ofdouglas/2kwMotorController/README.md

# 2kwMotorController
2 kilowatt brushed DC motor controller

This is a senior design project in Electrical and Computer Engineering at George Mason University.

All works are copyrighted by their respective authors.
