ofdouglas/2kwMotorController/firmware/MotorController/sw_arch.png

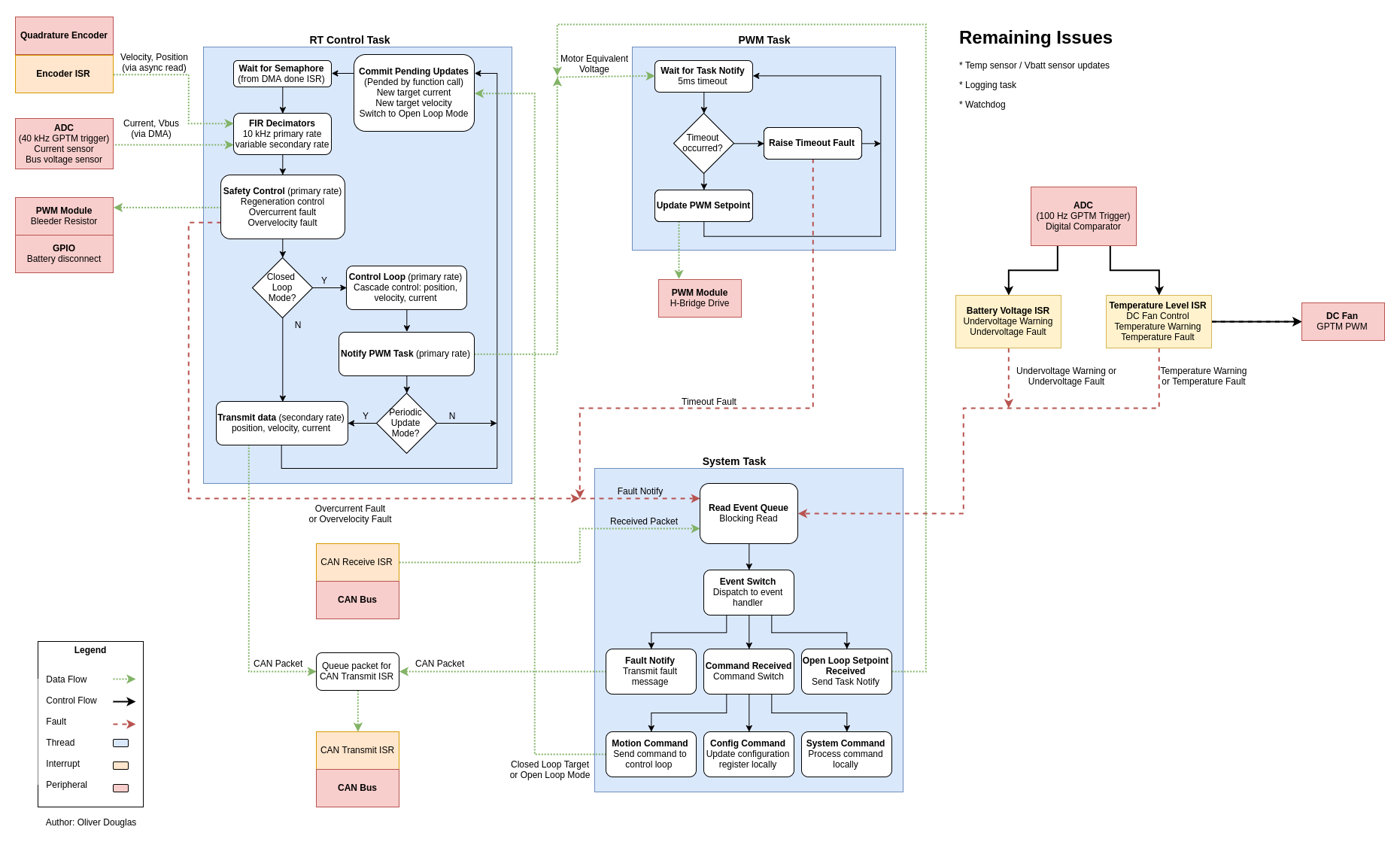
firmware/MotorController/sw_arch.png
