ofdouglas/2kwMotorController/notes/current-capacity.jpg

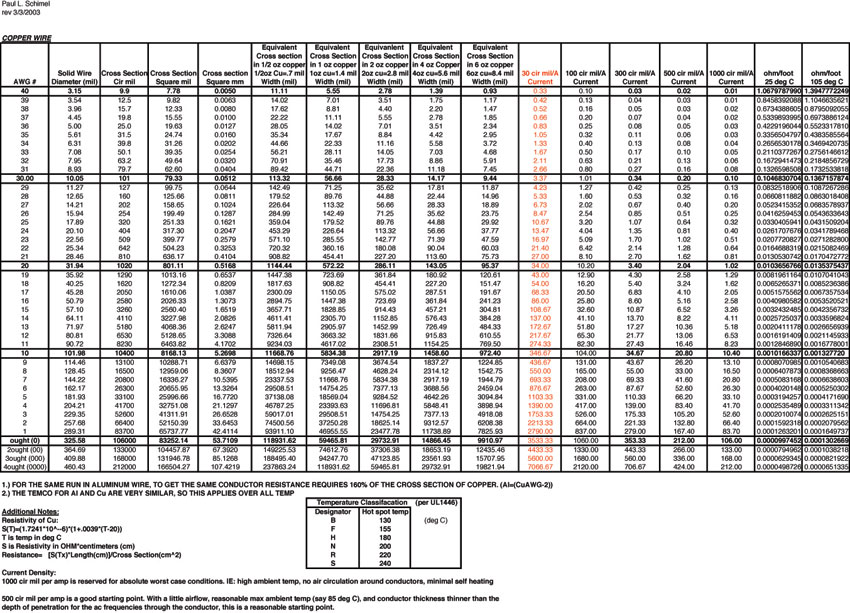
notes/current-capacity.jpg
