ofdouglas/2kwMotorController/firmware/MotorController/todo.txt

System task code
- configuration registers

improve UART command interface
- error checking
- more commands

Tune VBUS sensor

Current sensor

Test sensors over wider range
- Plot about 10 different values (ref. to multimeter)

Improve PWM driver

H-bridge safety functions

TODO: bugfixes
* panic_log_msg doesn't always work
