ofdouglas/2kwMotorController/sim/decoupling/inrush.asc

C1: cap; 1000µ
R1: res; 150
V1: voltage; PULSE(0 48 1u 1u 1n 1)
Named nets: 0, vc, vr
.tran 800m
.ic v(vc) = 0
