ofdouglas/2kwMotorController/sim/decoupling/decoupling.asc

C1: cap; 1000µ
C2: cap; {N*1µ}
I1: load; PULSE(0 45 0 50n 50n {0.5/fsw} {1/fsw})
L1: ind; 100n
L2: ind; 50n
L3: ind; 10n
L_esl: ind; {N*1.2n}
R1: res; 1m
R2: res; 150m
R3: res; 5m
R_esr: res; {N*568µ}
R_trace: res; {N*30m}
V1: voltage; 48
Named nets: 0, VC1, VC2, Vbus
.param fsw=20e3
.tran 100u
ESR = DF / (2*pi*f*C) 
Trise = 50n -> f ~= 7MHz  
Typical X7R DF for high voltage cap = 2%
MLCC Chip ESL (pF)
0603: 870
0805: 1050
1206: 1200
1210: 980
.param N = 1
Power loss in capacitors: V(VC2)*I(C2)
Peak power is a few watts, average power ~= 0
Power line inductance:
Microstrip over ground plane: L = 2h/w nH/cm
Cable in air: L = 2l(log(l/(t+w) + 1/2) nH (cm) 
(For a big cable: several nH/cm)
Very low R_trace is bad for stability (undamped LC, step excitation)
but watch for trace heating due to large transient current...
especially if significant ringing occurs
Aluminum Electrolytic
Ceramic (SMD)
