ofdouglas/2kwMotorController/sim/supply/lt3471.asc

C1: cap; 56p
C2: cap; 4.7µ; Rser=10m
C3: cap; 1µ
C4: cap; 4.7µ
C5: cap; 100n
C6: cap; 56p
C7: cap; 4.7µ
C8: cap; 0.1µ
D1: schottky; PMEG2005AEA
D2: schottky; PMEG2005AEA
I1: load; PWL(0 0 1m 0 1.001m 250m)
L1: ind; 10µ; Rser=182m
L2: ind; 10µ
L3: ind; 10µ
R1: res; 110k
R2: res; 10k
R3: res; 10k
R4: res; 120k
R5: res; 2.4k
R6: res; 2.4k
R7: res; 10k
RTEST: res; 1µ
U1: LT3471
V1: voltage; 7
Named nets: +12V, 0, -12V, SHDN
.tran 2.5m
.ic V(SHDN)=0
