ofdouglas/2kwMotorController/sim/hbridge-spice/proto.asc

C1: cap; 470µ; Rser=100m
C2: cap; 0.22µ
C4: cap; 0.22µ
C5: cap; 0.1µ
D1: diode; 1N4148
D2: diode; 1N4148
I_load_torque_external: current; 1
L6: ind; 1µ
L_parasitic_1: ind; 10n; Rser=1m
L_parasitic_2: ind; 10n; Rser=1m
L_parasitic_3: ind; 10n; Rser=1m
L_parasitic_4: ind; 10n; Rser=1m
M1: nmos; IPP037N08N3
M2: nmos; IPP037N08N3
M3: nmos; IPP037N08N3
M4: nmos; IPP037N08N3
M5: nmos; IPP037N08N3
M6: nmos; IPP037N08N3
M7: nmos; IPP037N08N3
M8: nmos; IPP037N08N3
R1: res; 5.1
R2: res; 5.1
R3: res; 5.1
R4: res; 5.1
R5: res; 5.1
R6: res; 27k
R7: res; 5.1
R8: res; 5.1
R9: res; 27k
R10: res; 5.1
Rsense: res; 1n
U1: voltage; 48; Rser=1m
U2: LM5106_TRANS
U3: cap; 0.1µ
U4: LM5106_TRANS
V1: voltage; PULSE(0 5 0 10n 10n 10e-6 50e-6 150)
V2: voltage; PULSE(0 5 0.0075 10n 10n 10e-6 50e-6 50)
V3: voltage; 5
VDD: voltage; 10; Rser=100m
X1: DC_motor_model
Named nets: 0, EN, IN_1, IN_2, VDD, M-, M+, omega
.tran 0.005
.lib LM5106_TRANS.lib
