ofdouglas/2kwMotorController/sim/hbridge-spice/brake/DC_motor_model.asc

Aenc: schmtinv; Vt=0.5 Vh=0.5 td=10n
Bemf: bv; V=k*V(omega)
Benc: bv; V=5*V(p)
Bp: bi; I=kenc*abs(v(omega))*(V(p)-0.5)
C_Jinertia: cap; {J}
Cenc: cap; 1m
I_load_torque_int: bi; I=sgn(v(omega))*min(Tint,0.1*abs(v(omega)))
Itorque: bi; I=k*I(Bemf)
LM: ind; 120µH
R1: res; 220
R_Bfriction: res; {1/B}
RM: res; {RM}
Named nets: enc, 0, omega, emf, p, +DC, -DC
.param kenc=0.49
ECEN2830
DC motor model
wheel speed [rad/s]
Encoder pulses
Encoder model
.param RM = 0.089
.param k = 0.0398
.param J = 0.064516
.param B = 0.0001
.param Tint = 0.05
Update These Parameters
(Do not make any other changes)
Electrical Model
Mechanical Model
E30-400 Unloaded:
.param RM = 0.089
.param k = 0.0398
.param J = 0.001256
.param B = 0.0001
.param Tint = 0.05
