ofdouglas/2kwMotorController/sim/sensor-spice/opto/photovoltaicMode.asc

C1: cap; 10p
C2: cap; 10p
C3: cap; 47n
R1: res; 470
R2: res; 120k
R3: res; 51k
R4: res; 47
R5: res; 18k
R6: res; 2k
U1: CNR200
U2: UniversalOpamp2; Avol=1Meg GBW=1Meg Slew=0.6Meg; ilimit=25m rail=0 Vos=0 phimargin=90
U3: UniversalOpamp2
U4: UniversalOpamp2; Avol=1Meg GBW=1Meg Slew=0.6Meg; ilimit=25m rail=0 Vos=0 phimargin=90
V1: voltage; 11.5
V2: voltage; 3.3
V3: voltage; ""; AC 1
V4: voltage; 10
V5: voltage; 0
Voffset: voltage; 6m
Named nets: 0, Vin, 10V, Vout, Vcc2, Vcc, VCC
.dc V3 1 75 0.1
.ac dec 100 1 10Meg
Vout = Vin * K3 * R3 / R2
K3 ~= 1
.param A = 0.0425
normalize V(vout) to 0dB: V(vout)*6700
