ofdouglas/2kwMotorController/sim/hbridge-spice/brake/busbrake-quick.asc

A1: and
A3: schmtbuf; Vt={Vbatt+1} Vh=0.5
C1: cap; 2mF; Rser=100m
C2: cap; 100n
E1: e; 10
L1: ind; 120µ
M1: nmos; IPP100N08N3
M2: nmos; IPP100N08N3
M3: nmos; IPP100N08N3
M4: nmos; IPP100N08N3
M5: nmos; IPP100N08N3
M6: nmos; IPP100N08N3
Motor: res; 0.089
R1: res; 800
Rbrake: res; 1; pwr=200
Rsense: res; 1µ
V4: voltage; PULSE(0 1 0 1n 1n 0e-6 50e-6)
Vbrake: voltage; 0
Vbus: voltage; {Vbatt}; Rser=2m
Vbus_dis: voltage; PWL(0 10 {t_drive} 10 {t_drive + 0.1m} 0)
Vdir: voltage; 0
Vduty: voltage; PWL(0 0.42 {t_drive} 0.98 {t_drive + 0.1m} 0.21)
Vgen: voltage; 20
Vmode: voltage; 1
X1: GateDriver
Named nets: Vduty, 0, Vdir, Vbrake, Vmode, M+, M-, HO1, LO1, HO2, LO2, Vbus
.tran {t_drive + 0.05}
.param t_drive=0.02
.param Vbatt=48V
.ic I(L1)=90A
