ofdouglas/2kwMotorController/sim/hbridge-spice/brake/busbrake.asc

A1: and
A3: schmtbuf; Vt={Vbatt+1} Vh=1
C2: cap; 100n
Cbus: cap; 1mF; Rser=50m
D1: schottky; MBR735
D2: schottky; MBR735
D3: schottky; MBR735
D4: schottky; MBR735
E1: e; 10
E2: e; 9.55e-3
I1: current; 0.1
M1: nmos; IPP100N08N3
M2: nmos; IPP100N08N3
M3: nmos; IPP100N08N3
M4: nmos; IPP100N08N3
M5: nmos; IPP100N08N3
M6: nmos; IPP100N08N3
Motor: res; 1µ
R1: res; 800
R2: res; 250
R3: res; 250
R4: res; 250
R5: res; 250
Rbrake: res; 1; pwr=200
Rsense: res; 1µ
V4: voltage; PULSE(0 1 0 1n 1n 50e-6 50e-6)
Vbattery: voltage; {Vbatt}; Rser=2m
Vbrake: voltage; 0
Vbus_dis: voltage; PWL(0 10 {t_drive} 10 {t_drive + 0.1m} 0)
Vdir: voltage; 0
Vduty: voltage; PWL(0 0.98 {t_drive} 0.98 {t_drive + 0.1m} 0.3)
Vmode: voltage; 1
X1: GateDriver
X2: DC_motor_model
Named nets: Vduty, 0, Vdir, Vbrake, Vmode, M+, M-, HO2, HO1, LO1, LO2, Vbus, rad/s, krpm
.tran {t_drive + 0.1}
.param t_drive=0.1
.param Vbatt=48V
Demonstration of regenerative braking effect when
reducing duty cycle in sign-magnitude drive mode.
 
If Vbus_dis remains on, Vbattery will overcharge.
If Vbus_dis is turned off, but Rbrake is not utilized,
Vbus will become overcharged.
Brake power: V(Vbus,N001)*I(Rbrake)
