ofdouglas/2kwMotorController/sim/sensor-spice/hall/hallsensor.asc

C1: cap; 47n
C2: cap; 27n
Isense: current; PULSE(0 50mA 100u 1n 0 1 1); AC 1
R1: res; 100k
R2: res; 100k
R3: res; 33
Radj: res; 59.0
Rsense: res; 59.0; pwr=0.2
U3: ADA4805
VDDA: voltage; 3.3
VREF: voltage; 3.0
Named nets: 0, Vadc, Vsense
.dc Isense 0 45m 1m
.param fpwm 20k
.tran 2m
I_sense value for ripple current sim:
PULSE(10 12mA 0 {0.5/fpwm} {0.5/fpwm} 0 {1/fpwm})
.op
200mW
0.1%
I_primary = (Vadc - 1.50) * 67.8
I_sense = I_motor / 2000
RRIO op amp
SAR ADC input drive
stable dielectric 
such as C0G
.ac dec 100 1 10Meg
