ofdouglas/2kwMotorController/sim/hbridge-spice/brake/BrakeResistor.asc

L1: ind; 120µH
M1: nmos; IPB016N06L3
M3: pmos; RSS070P05
R1: res; 0.1
R2: res; 1
V1: voltage; 24
V2: voltage; PULSE(0 10 0 1n 1n 44e-6 50e-6)
Named nets: 0, pwm
.tran 10m
DC motor equivalent
Brake resistor
