ofdouglas/2kwMotorController/sim/hbridge-spice/brake/GateDriver.asc

A1: and
A2: inv
A3: inv
A4: or
A5: and
A6: and
A7: and
A8: inv
A9: inv
A10: inv
A11: and
A12: or
A13: inv
A14: inv
A16: and
A18: and
A19: or
A20: inv
A21: and
A23: inv
A24: inv
A25: inv
A26: and
A27: inv
A32: and
A34: inv
A36: inv
E1: e; 10V
E2: e; 10V
E3: e; 10V
E4: e; 10V
R1: res; 1Meg
R2: res; 1Meg
R3: res; 1Meg
R4: res; 1Meg
U1: LTC6752
V2: voltage; PULSE(0 1 0 {0.99/fs} {0.01/fs} 0 {1/fs})
VDD: voltage; 5
Named nets: 0, PWM, DIR, BRAKE, MODE, LO2_EN, LO1_EN, HO1_EN, HO2_EN, HS1, HO1, HS2, HO2, LO1, LO2, DUTY, Vsawtooth
.param fs=20kHz
Apply a DC voltage between 0 and 1V to the DUTY, MODE,  
BRAKE, and DIR inputs. Or use the 'PWL' voltage source to  
create step changes in these inputs.
 
DUTY: analog signal controlling duty cycle (0.4V = 40%, etc) 
           when BRAKE is applied, this controls brake/coast ratio 
 
MODE:    digital signal: 0 = coast; 1 = short.
BRAKE: digital signal: 0 = drive; 1 = brake. 
DIR:         digital signal: 0 = clockwise (M+ -> M-)
