ofdouglas/2kwMotorController/sim/hbridge-spice/drive-modes/async_sm-discontinuous.asc

L1: ind; 120µH
M1: nmos; IPP037N08N3
M2: nmos; IPP037N08N3
M3: nmos; IPP037N08N3
M4: nmos; IPP037N08N3
Motor: res; 1n
R1: res; 10
R2: res; 10
R3: res; 10
R4: res; 10
R5: res; 10
R6: res; 0.089
V1: voltage; PULSE(0 20 0 1n 1n 45e-6 50e-6 200)
V2: voltage; 50
V3: voltage; PULSE(0 20 10m 1n 1n 15e-6 50e-6)
V_bus: voltage; 24; Rser=0
V_gen: voltage; 20
Named nets: 0, M-, M+
.tran 0.02
Demonstration of discontinuous conduction mode at low duty cycle:
 Switch from 90% duty cycle to 30% duty cycle after 10 ms
 Because V_bus * Duty < V_gen, average motor current is zero
Asynchronous Sign-Magnitude Drive Mode (AKA unipolar 2-quadrant PWM)
