ofdouglas/2kwMotorController/sim/sensor-spice/opto/opto-amp-gain.asc

D1: diode; 1N4148
E1: e; 100k
F1: f; E1; 0.007
R1: res; 10k
R2: res; 470
V1: voltage; 48
V2: voltage; 12
Named nets: 0, Vout, Vin
.tf V(Vout) V1
