ofdouglas/2kwMotorController/hardware/2kwMotorController.kicad_pcb

## KiCad design hardware/2kwMotorController.kicad_pcb (2017-11-27)

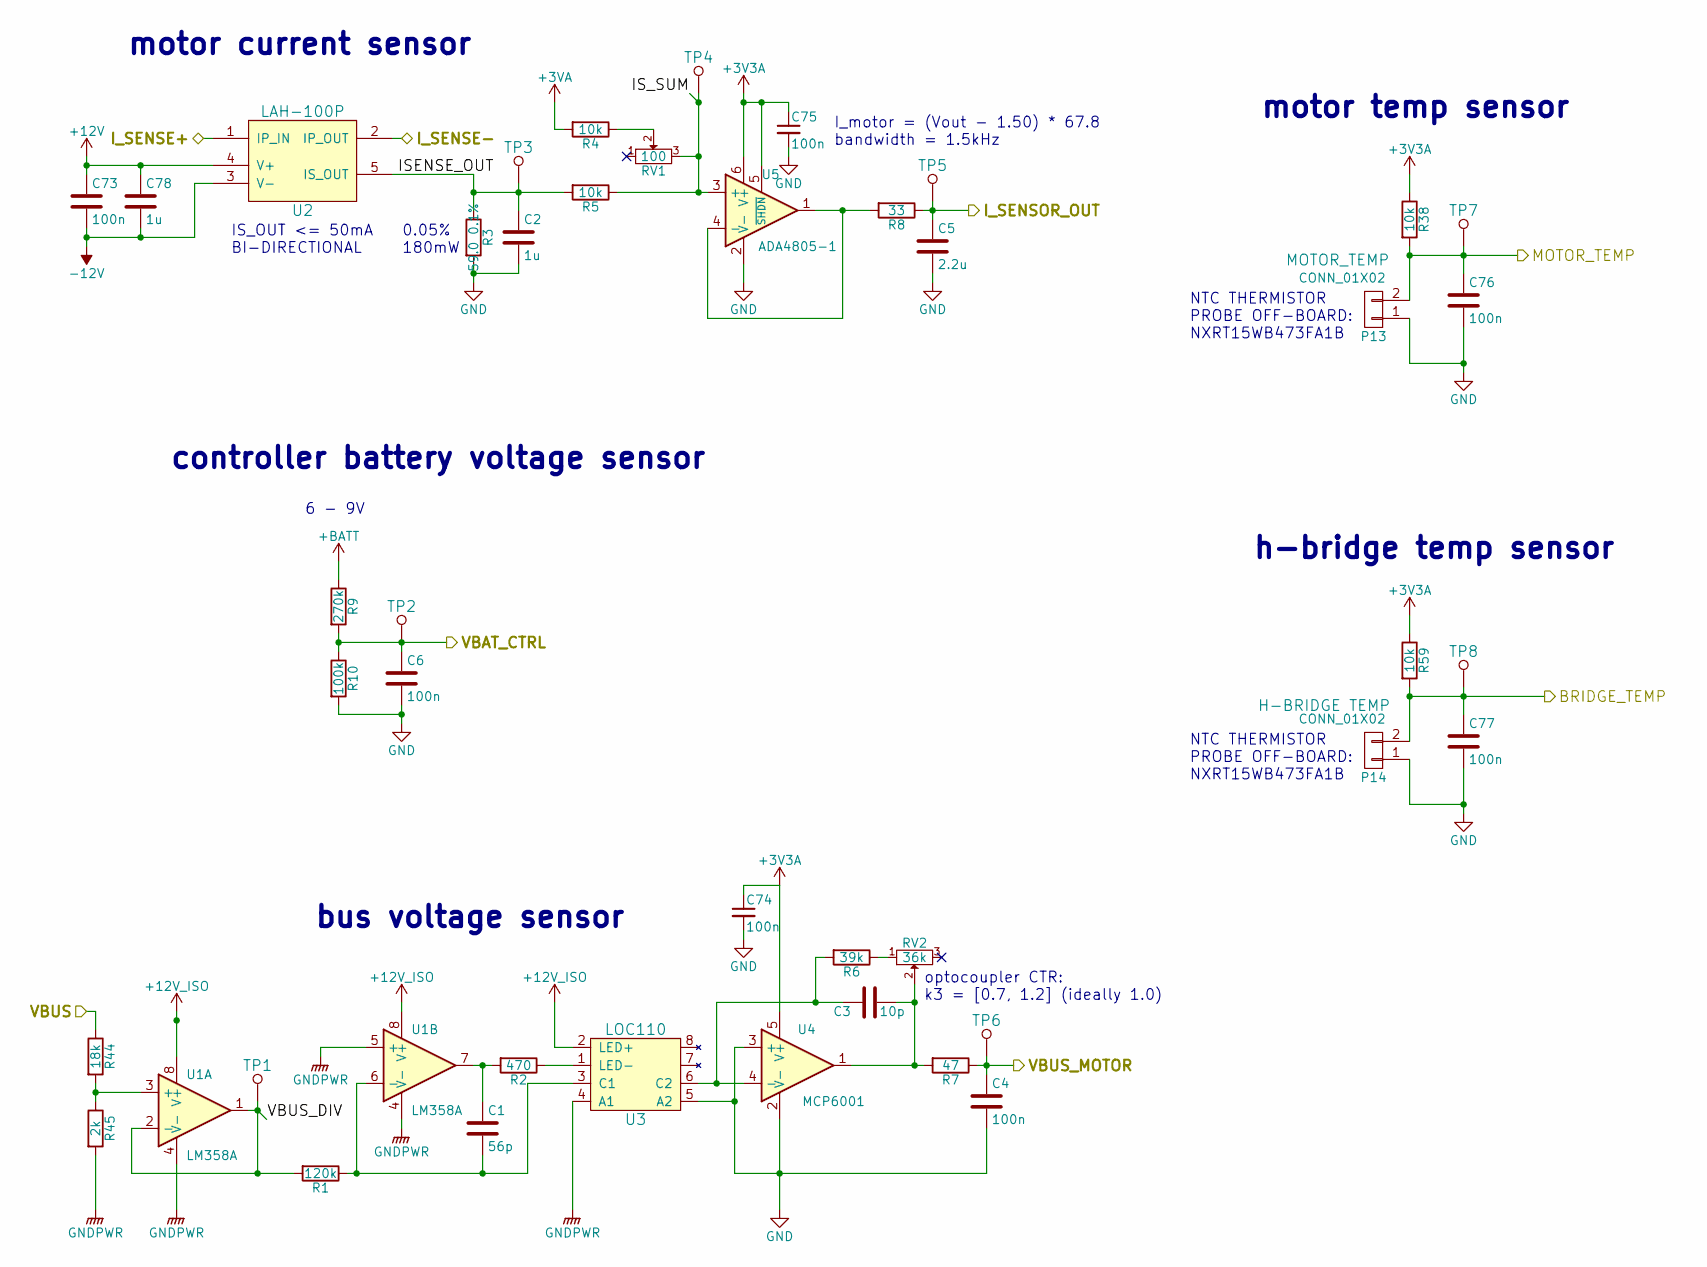
[picture p3: schematic sensors.sch]

Parts:
C1: 56p; C_0603; Voltage 16V
C2: 1u; C_0603; Voltage 16V
C3: 10p; C_0603; Voltage 16V
C4, C6, C74, C75, C76, C77: 100n; C_0603; Voltage 16V
C5: 2.2u; C_0603; Voltage 16V
C73: 100n; C_0603; Voltage 25V
C78: 1u; C_0603; Voltage 25V
P13, P14: CONN_01X02; Pin_Header_Straight_1x02
R1: 120k; R_0603
R2: 470; R_0603
R3: 59.0 0.1%; R_1206
R4, R5, R38, R59: 10k; R_0603
R6: 39k; R_0603
R7: 47; R_0603
R8: 33; R_0603
R9: 270k; R_0603
R10: 100k; R_0603
R44: 18k; R_0603
R45: 2k; R_0603
RV1: 100; Trimpot-23B
RV2: 36k; Trimpot-23B
TP1, TP2, TP3, TP4, TP5, TP6, TP7, TP8: TEST_POINT; TEST_PAD_1.27mm
U1: LM358A; SOIC-8_3.9x4.9mm_Pitch1.27mm
U2: LAH-100P; LAH_100-P
U3: LOC110; DIP-8_SMD
U4: MCP6001; SC-70-5
U5: ADA4805-1; SOT-23-6

Connections:
+3V3A: C74.1, C75.1, R38.1, R59.1, U4.5 (V+), U5.5 (~SHDN), U5.6 (V+); also elsewhere on the board
+3VA: R4.2; also elsewhere on the board
+12V: C73.1, C78.1, U2.4 (V+); also elsewhere on the board
+12V_ISO: U1.8 (V+), U3.2 (LED+); also elsewhere on the board
+BATT: R9.1; also elsewhere on the board
-12V: C73.2, C78.2, U2.3 (V-); also elsewhere on the board
/h-bridge/I_SENSE+: U2.1 (IP_IN); also elsewhere on the board
/h-bridge/I_SENSE-: U2.2 (IP_OUT); also elsewhere on the board
/h-bridge/VBUS: R44.1; also elsewhere on the board
/mcu/BRIDGE_TEMP: C77.1, P14.2, R59.2, TP8.1; also elsewhere on the board
/mcu/I_SENSOR_OUT: C5.1, R8.1, TP5.1; also elsewhere on the board
/mcu/MOTOR_TEMP: C76.1, P13.2, R38.2, TP7.1; also elsewhere on the board
/mcu/VBAT_CTRL: C6.1, R9.2, R10.1, TP2.1; also elsewhere on the board
/mcu/VBUS_MOTOR: C4.1, R7.1, TP6.1; also elsewhere on the board
/sensors/ISENSE_OUT: C2.1, R3.1, R5.2, TP3.1, U2.5 (IS_OUT)
/sensors/IS_SUM: R5.1, RV1.3, TP4.1, U5.3 (+)
/sensors/VBUS_DIV: R1.2, TP1.1, U1.1, U1.2 (-)
GND: C2.2, C4.2, C5.2, C6.2, C74.2, C75.2, C76.2, C77.2, P13.1, P14.1, R3.2, R10.2, U3.5 (A2), U4.2 (V-), U4.3 (+), U5.2 (V-); also elsewhere on the board
GNDPWR: R45.2, U1.4 (V-), U1.5 (+), U3.4 (A1); also elsewhere on the board
unnamed: C1.1, R2.2, U1.7
unnamed: C1.2, R1.1, U1.6 (-), U3.3 (C1)
unnamed: C3.1, R6.2, U3.6 (C2), U4.4 (-)
unnamed: C3.2, R7.2, RV2.2, U4.1
unnamed: R2.1, U3.1 (LED-)
unnamed: R4.1, RV1.2
unnamed: R6.1, RV2.1
unnamed: R8.2, U5.1, U5.4 (-)
unnamed: R44.2, R45.1, U1.3 (+)

Notes on the sheet:
IS_OUT <= 50mA BI-DIRECTIONAL
motor current sensor
h-bridge temp sensor
controller battery voltage sensor
bus voltage sensor
6 - 9V
optocoupler CTR: k3 = [0.7, 1.2] (ideally 1.0)
I_motor = (Vout - 1.50) * 67.8 bandwidth = 1.5kHz
0.05% 180mW
motor temp sensor
NTC THERMISTOR PROBE OFF-BOARD: NXRT15WB473FA1B

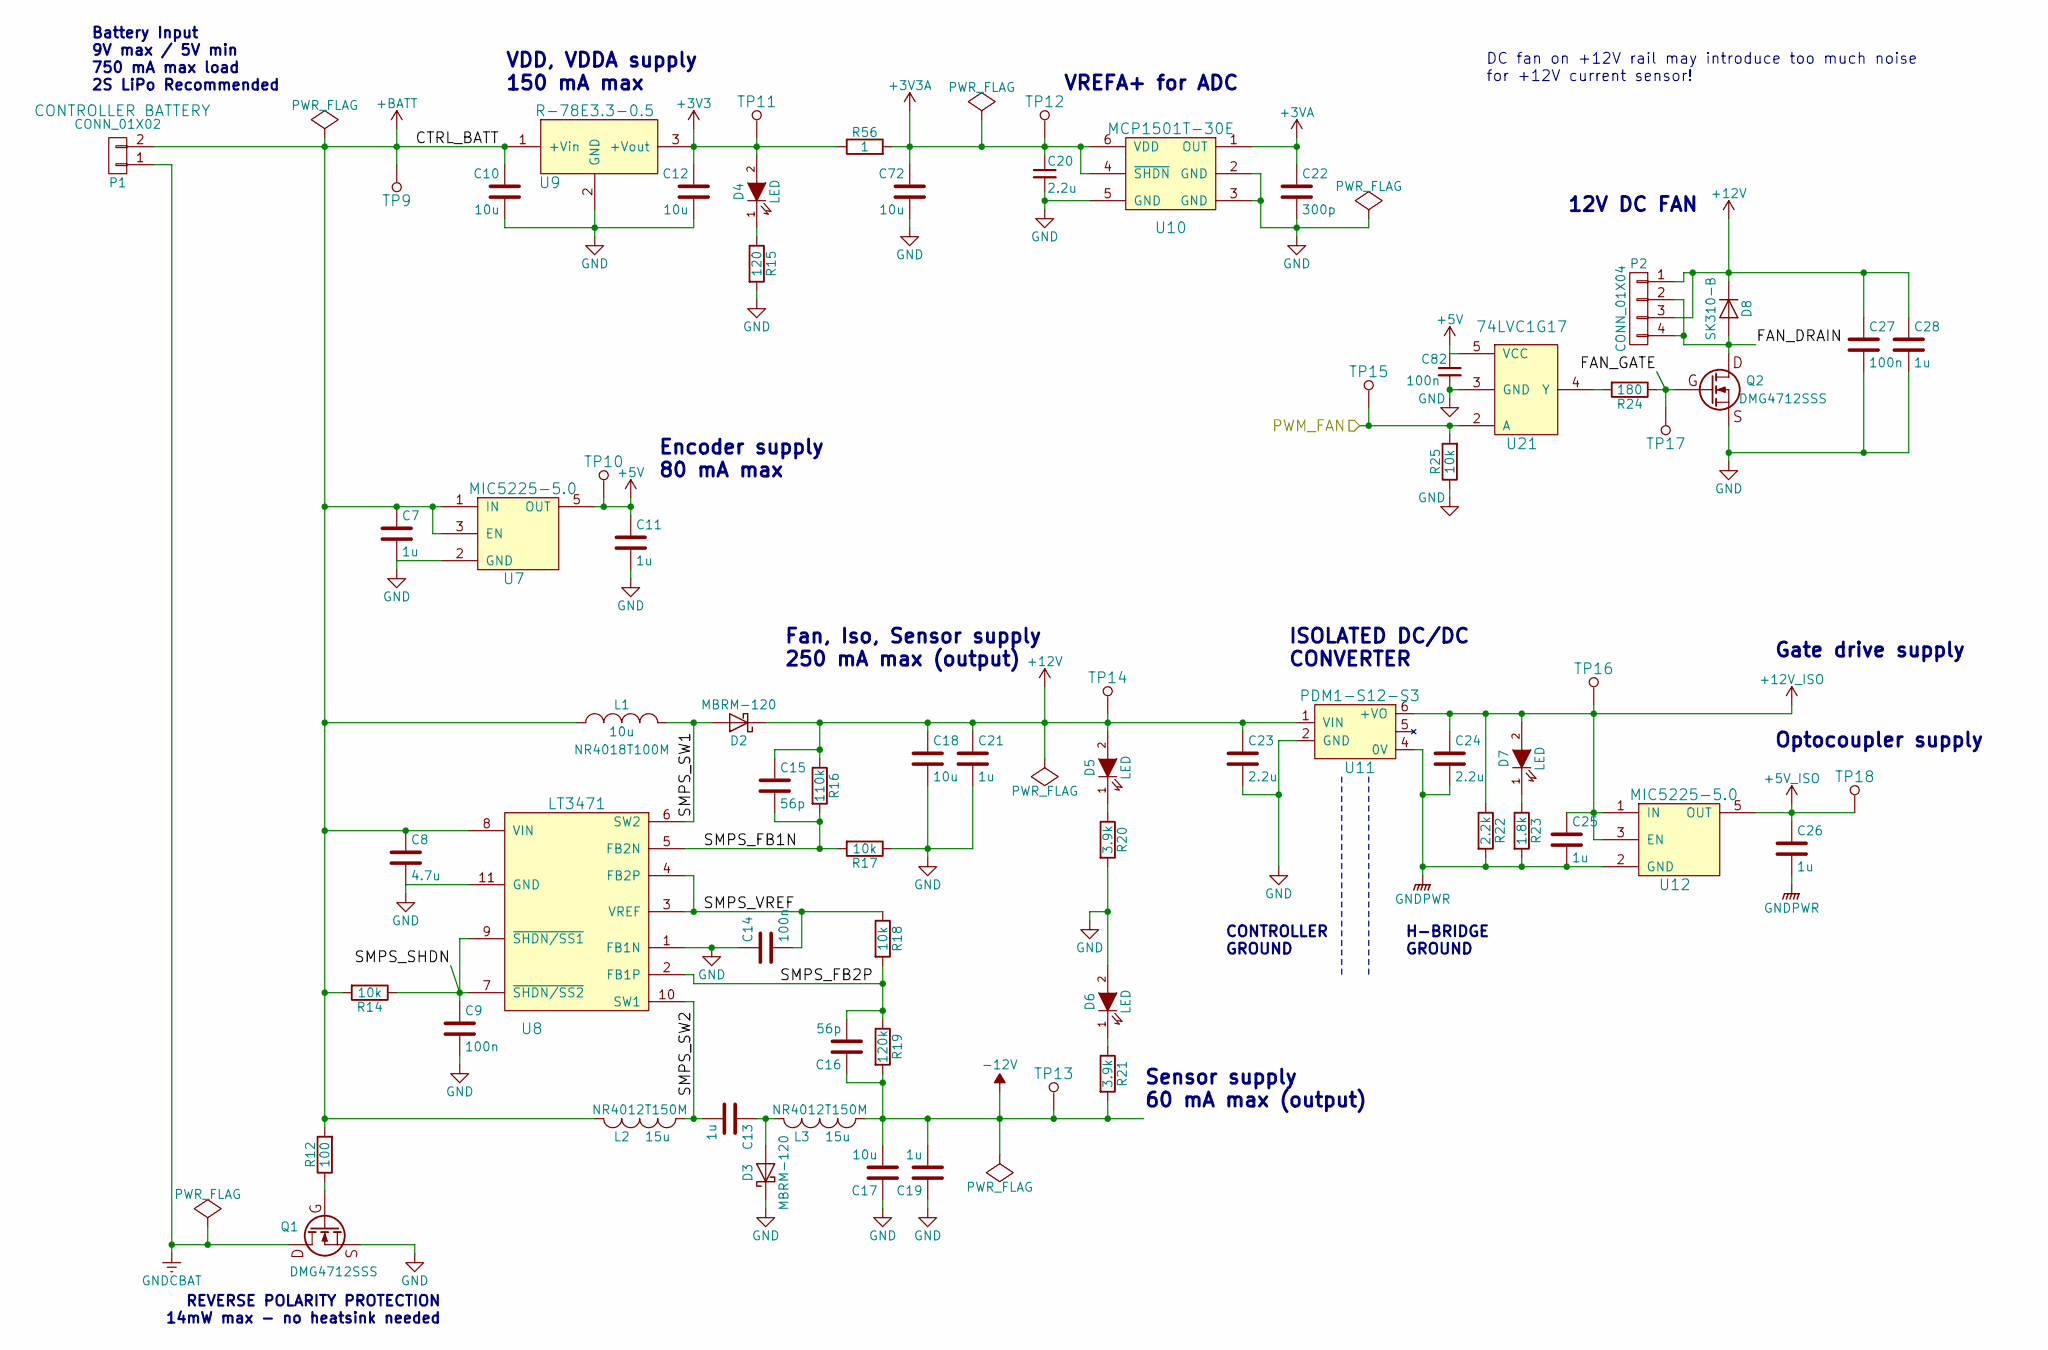
[picture p4: schematic power.sch]

Parts:
C7, C11: 1u; C_0603; Voltage 16V
C8: 4.7u; C_0603; Voltage 25V
C9, C14, C27, C82: 100n; C_0603; Voltage 25V
C10, C12, C72: 10u; C_0805; Voltage 16V
C13: 1u; C_0603
C15, C16: 56p; C_0603; Voltage 25V
C17, C18: 10u; C_0805; Voltage 25V
C19, C21, C25, C26, C28: 1u; C_0603; Voltage 25V
C20: 2.2u; C_0603; Voltage 16V
C22: 300p; C_0603; Voltage 16V
C23, C24: 2.2u; C_0603; Voltage 25V
D2, D3: MBRM-120; DIODE_POWERMITE
D4, D5, D6, D7: LED; LED_0603
D8: SK310-B; DIODE_POWERMITE
L1: 10u; INDUCTOR_NR40xx
L2, L3: 15u; INDUCTOR_NR40xx
P1: CONN_01X02; Pin_Header_Straight_1x02
P2: CONN_01X04; TERM_4P_2-4_1990025
Q1, Q2: DMG4712SSS; SOIC-8_3.9x4.9mm_Pitch1.27mm
R12: 100; R_0603
R14, R17, R18, R25: 10k; R_0603
R15: 120; R_0603
R16: 110k; R_0603
R19: 120k; R_0603
R20, R21: 3.9k; R_0603
R22: 2.2k; R_0603
R23: 1.8k; R_0603
R24: 180; R_0603
R56: 1; R_0603
TP9, TP10, TP11, TP12, TP13, TP14, TP15, TP16, TP17, TP18: TEST_POINT; TEST_PAD_1.27mm
U7, U12: MIC5225-5.0; SOT-23-5
U8: LT3471; DFN-10-1EP_3x3mm_Pitch0.5mm
U9: R-78E3.3-0.5; R-78E-0.5
U10: MCP1501T-30E; SOT-23-6
U11: PDM1-S12-S3; PDM2-S
U21: 74LVC1G17; SC-74A

Connections:
+3V3A: C20.1, C72.1, R56.2, TP12.1, U10.4 (~SHDN), U10.6 (VDD); also elsewhere on the board
+3VA: C22.1, U10.1 (OUT); also elsewhere on the board
+5V: C11.1, C82.1, TP10.1, U7.5 (OUT), U21.5 (VCC); also elsewhere on the board
+5V_ISO: C26.1, TP18.1, U12.5 (OUT); also elsewhere on the board
+12V: C15.1, C18.1, C21.1, C23.1, C27.1, C28.1, D2.1 (K), D5.2 (A), D8.1 (K), P2.1, P2.3, R16.1, TP14.1, U11.1 (VIN); also elsewhere on the board
+12V_ISO: C24.1, C25.1, D7.2 (A), R22.1, TP16.1, U11.6 (+VO), U12.1 (IN), U12.3 (EN); also elsewhere on the board
+BATT: C7.1, C8.1, C10.1, L1.1, L2.1, P1.2, R12.2, R14.2, TP9.1, U7.1 (IN), U7.3 (EN), U8.8 (VIN), U9.1 (+Vin); also elsewhere on the board
-12V: C16.1, C17.2, C19.2, L3.2, R19.2, R21.2, TP13.1; also elsewhere on the board
/mcu/PWM_FAN: R25.2, TP15.1, U21.2 (A); also elsewhere on the board
/power/FAN_DRAIN: D8.2 (A), P2.2, P2.4, Q2.5 (D), Q2.6 (D), Q2.7 (D), Q2.8 (D)
/power/FAN_GATE: Q2.4 (G), R24.1, TP17.1
/power/SMPS_FB1N: C15.2, R16.2, R17.2, U8.5 (FB2N)
/power/SMPS_FB2P: C16.2, R18.2, R19.1, U8.2 (FB1P)
/power/SMPS_SHDN: C9.1, R14.1, U8.7 (~SHDN/SS2), U8.9 (~SHDN/SS1)
/power/SMPS_SW1: D2.2 (A), L1.2, U8.6 (SW2)
/power/SMPS_SW2: C13.2, L2.2, U8.10 (SW1)
/power/SMPS_VREF: C14.2, R18.1, U8.3 (VREF), U8.4 (FB2P)
GND: C7.2, C8.2, C9.2, C10.2, C11.2, C12.2, C14.1, C17.1, C18.2, C19.1, C20.2, C21.2, C22.2, C23.2, C27.2, C28.2, C72.2, C82.2, D3.1 (K), D6.2 (A), Q1.1 (S), Q1.2 (S), Q1.3 (1), Q2.1 (S), Q2.2 (S), Q2.3 (1), R15.2, R17.1, R20.2, R25.1, U7.2 (GND), U8.1 (FB1N), U8.11 (GND), U9.2 (GND), U10.2 (GND), U10.3 (GND), U10.5 (GND), U11.2 (GND), U21.3 (GND); also elsewhere on the board
GNDCBAT: P1.1, Q1.5 (D), Q1.6 (D), Q1.7 (D), Q1.8 (D)
GNDPWR: C24.2, C25.2, C26.2, R22.2, R23.2, U11.4 (0V), U12.2 (GND); also elsewhere on the board
unnamed: C13.1, D3.2 (A), L3.1
unnamed: D4.1 (K), R15.1
unnamed: D5.1 (K), R20.1
unnamed: D6.1 (K), R21.1
unnamed: D7.1 (K), R23.1
unnamed: Q1.4 (G), R12.1
unnamed: R24.2, U21.4 (Y)

Notes on the sheet:
Battery Input 9V max / 5V min 750 mA max load 2S LiPo Recommended
REVERSE POLARITY PROTECTION 14mW max - no heatsink needed
H-BRIDGE GROUND
CONTROLLER GROUND
ISOLATED DC/DC CONVERTER
DC fan on +12V rail may introduce too much noise for +12V current sensor!
VREFA+ for ADC
VDD, VDDA supply 150 mA max
Fan, Iso, Sensor supply 250 mA max (output)
Sensor supply 60 mA max (output)
Optocoupler supply
Gate drive supply
Encoder supply 80 mA max
12V DC FAN

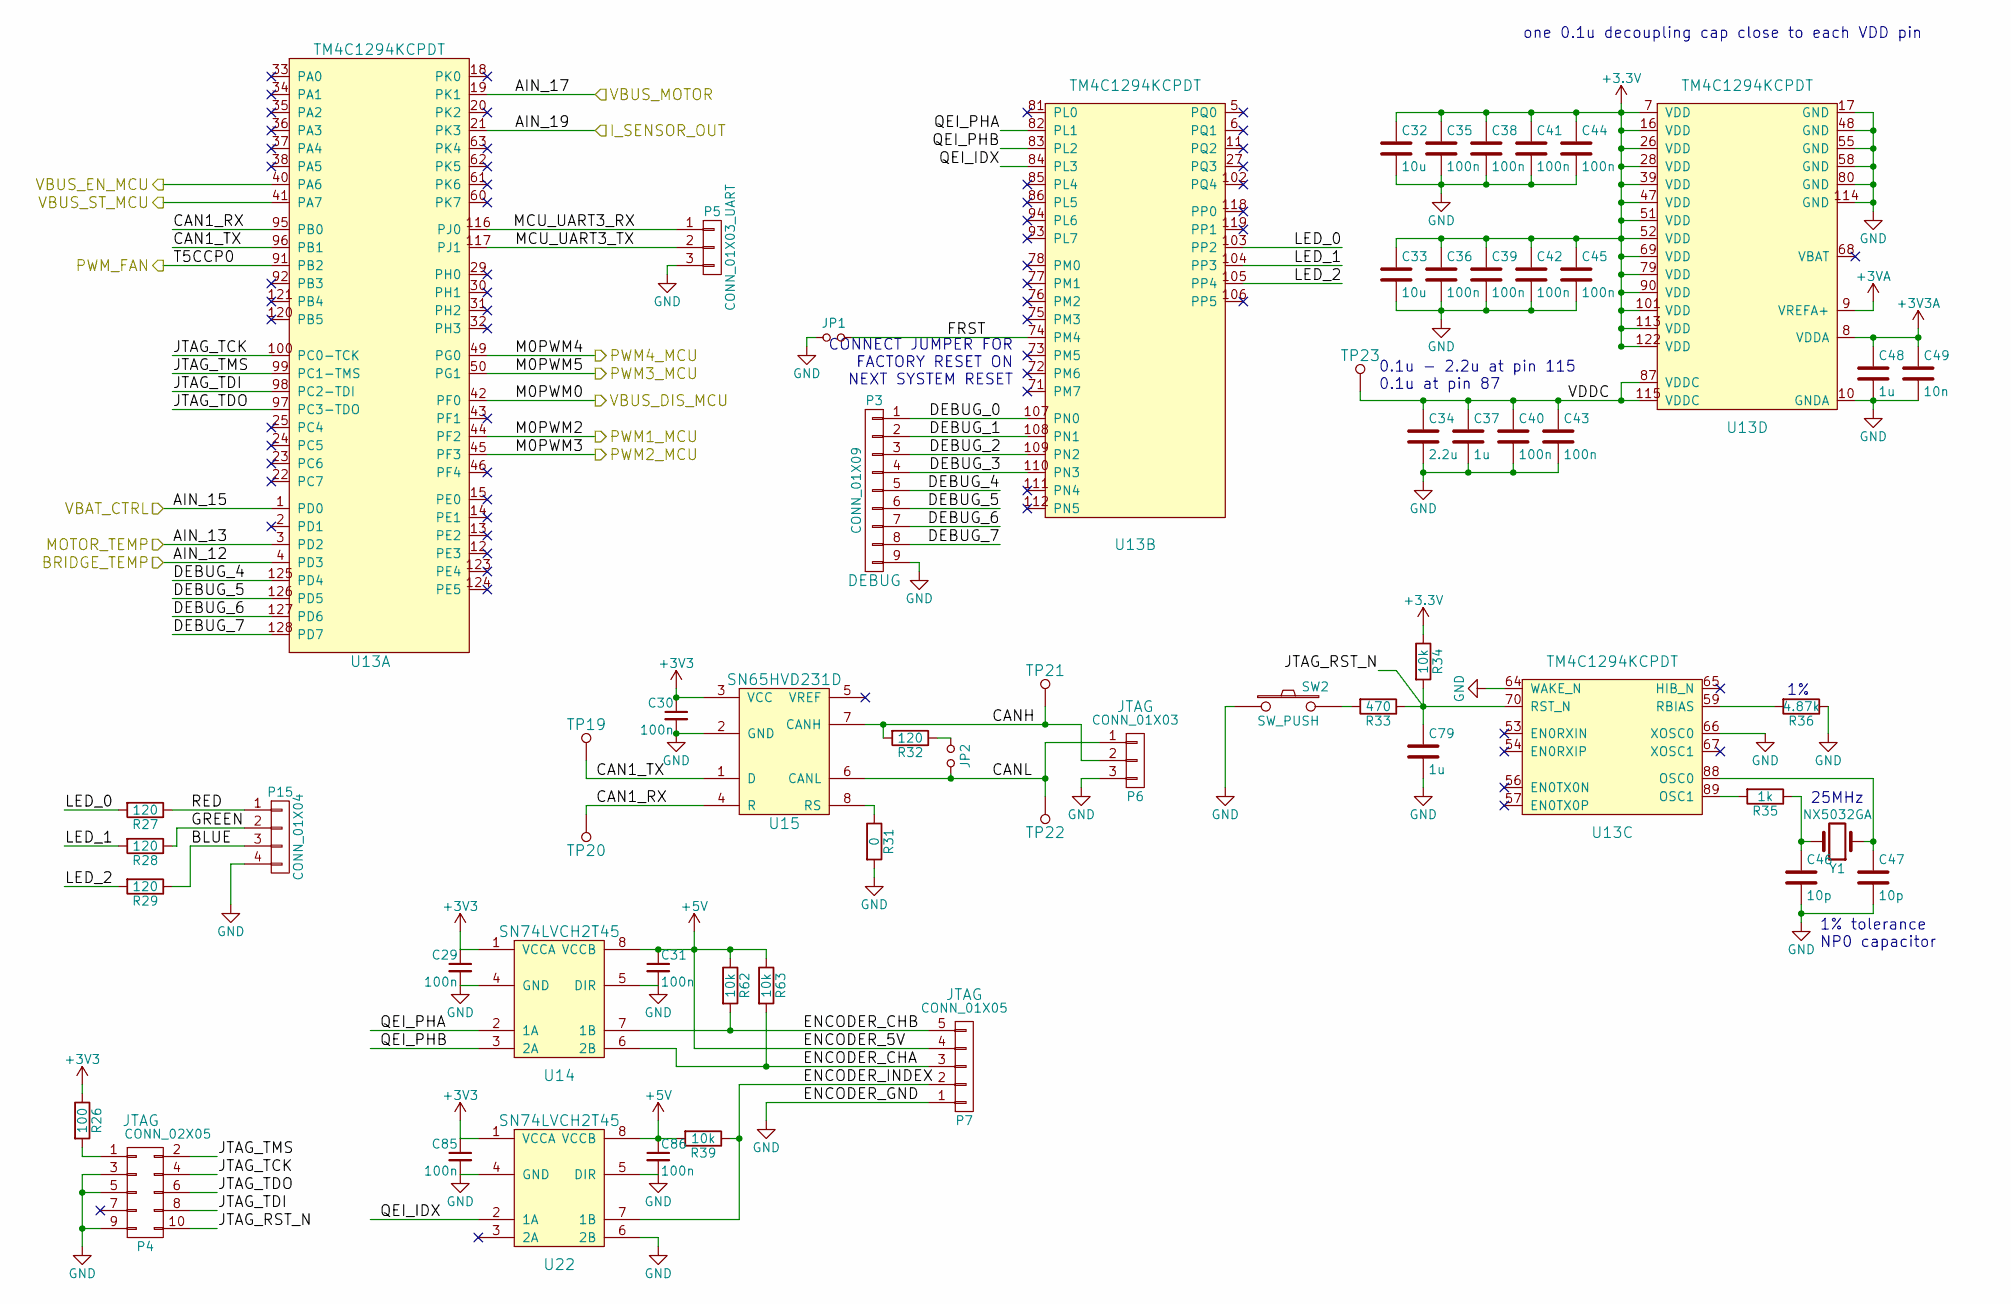
[picture p5: schematic mcu.sch]

Parts:
C29, C30, C31, C35, C36, C38, C39, C40, C41, C42, C43, C44, C45, C85, C86: 100n; C_0603; Voltage 16V
C32, C33: 10u; C_0805; Voltage 16V
C34: 2.2u; C_0603; Voltage 16V
C37, C48, C79: 1u; C_0603; Voltage 16V
C46, C47: 10p; C_0603; Voltage 16V
C49: 10n; C_0603; Voltage 16V
JP1, JP2: Jumper_NO_Small; Pin_Header_Straight_1x02
P3: CONN_01X09; Pin_Header_Straight_1x09
P4: CONN_02X05; Pin_Header_Straight_2x05_Pitch1.27mm
P5: CONN_01X03_UART; Pin_Header_Straight_1x03
P6: CONN_01X03; Pin_Header_Straight_1x03
P7: CONN_01X05; Pin_Header_Straight_1x05
P15: CONN_01X04; Pin_Header_Straight_1x04
R26: 100; R_0603
R27, R28, R29, R32: 120; R_0603
R31: 0; R_0603
R33: 470; R_0603
R34, R39, R62, R63: 10k; R_0603
R35: 1k; R_0603
R36: 4.87k; R_0603
SW2: SW_PUSH; SW_PUSH_SMALL
TP19, TP20, TP21, TP22, TP23: TEST_POINT; TEST_PAD_1.27mm
U13: TM4C1294KCPDT; TQFP-128_14x14mm_Pitch0.4mm_LONG
U14, U22: SN74LVCH2T45; MSOP-8_3x3mm_Pitch0.65mm
U15: SN65HVD231D; SOIC-8_3.9x4.9mm_Pitch1.27mm
Y1: NX5032GA; NX5032GA-CRYSTAL

Connections:
+3V3A: C48.1, C49.1, U13.8 (VDDA); also elsewhere on the board
+3VA: U13.9 (VREFA+); also elsewhere on the board
+5V: C31.1, C86.1, P7.4, R39.2, R62.1, R63.1, U14.8 (VCCB), U22.8 (VCCB); also elsewhere on the board
/h-bridge/PWM1_MCU: U13.44 (PF2); also elsewhere on the board
/h-bridge/PWM2_MCU: U13.45 (PF3); also elsewhere on the board
/h-bridge/PWM3_MCU: U13.50 (PG1); also elsewhere on the board
/h-bridge/PWM4_MCU: U13.49 (PG0); also elsewhere on the board
/h-bridge/VBUS_DIS_MCU: U13.42 (PF0); also elsewhere on the board
/h-bridge/VBUS_EN_MCU: U13.40 (PA6); also elsewhere on the board
/h-bridge/VBUS_ST_MCU: U13.41 (PA7); also elsewhere on the board
/mcu/BLUE: P15.3, R29.1
/mcu/BRIDGE_TEMP: U13.4 (PD3); also elsewhere on the board
/mcu/CAN1_RX: TP20.1, U13.95 (PB0), U15.4 (R)
/mcu/CAN1_TX: TP19.1, U13.96 (PB1), U15.1 (D)
/mcu/CANH: P6.2, R32.2, TP21.1, U15.7 (CANH)
/mcu/CANL: JP2.2, P6.1, TP22.1, U15.6 (CANL)
/mcu/DEBUG_0: P3.1, U13.107 (PN0)
/mcu/DEBUG_1: P3.2, U13.108 (PN1)
/mcu/DEBUG_2: P3.3, U13.109 (PN2)
/mcu/DEBUG_3: P3.4, U13.110 (PN3)
/mcu/DEBUG_4: P3.5, U13.125 (PD4)
/mcu/DEBUG_5: P3.6, U13.126 (PD5)
/mcu/DEBUG_6: P3.7, U13.127 (PD6)
/mcu/DEBUG_7: P3.8, U13.128 (PD7)
/mcu/ENCODER_CHA: P7.3, R63.2, U14.6 (2B)
/mcu/ENCODER_CHB: P7.5, R62.2, U14.7 (1B)
/mcu/ENCODER_INDEX: P7.2, R39.1, U22.7 (1B)
/mcu/FRST: JP1.1, U13.74 (PM4)
/mcu/GREEN: P15.2, R28.1
/mcu/I_SENSOR_OUT: U13.21 (PK3); also elsewhere on the board
/mcu/JTAG_RST_N: C79.1, P4.10, R33.1, R34.2, U13.70 (RST_N)
/mcu/JTAG_TCK: P4.4, U13.100 (PC0-TCK)
/mcu/JTAG_TDI: P4.8, U13.98 (PC2-TDI)
/mcu/JTAG_TDO: P4.6, U13.97 (PC3-TDO)
/mcu/JTAG_TMS: P4.2, U13.99 (PC1-TMS)
/mcu/LED_0: R27.2, U13.103 (PP2)
/mcu/LED_1: R28.2, U13.104 (PP3)
/mcu/LED_2: R29.2, U13.105 (PP4)
/mcu/MCU_UART3_RX: P5.1, U13.116 (PJ0)
/mcu/MCU_UART3_TX: P5.2, U13.117 (PJ1)
/mcu/MOTOR_TEMP: U13.3 (PD2); also elsewhere on the board
/mcu/PWM_FAN: U13.91 (PB2); also elsewhere on the board
/mcu/QEI_IDX: U13.84 (PL3), U22.2 (1A)
/mcu/QEI_PHA: U13.82 (PL1), U14.2 (1A)
/mcu/QEI_PHB: U13.83 (PL2), U14.3 (2A)
/mcu/RED: P15.1, R27.1
/mcu/VBAT_CTRL: U13.1 (PD0); also elsewhere on the board
/mcu/VBUS_MOTOR: U13.19 (PK1); also elsewhere on the board
/mcu/VDDC: C34.1, C37.1, C40.1, C43.1, TP23.1, U13.87 (VDDC), U13.115 (VDDC)
GND: C29.2, C30.2, C31.2, C32.2, C33.2, C34.2, C35.2, C36.2, C37.2, C38.2, C39.2, C40.2, C41.2, C42.2, C43.2, C44.2, C45.2, C46.2, C47.2, C48.2, C49.2, C79.2, C85.2, C86.2, JP1.2, P3.9, P4.3, P4.5, P4.9, P5.3, P6.3, P7.1, P15.4, R31.2, R36.1, SW2.1, U13.10 (GNDA), U13.17 (GND), U13.48 (GND), U13.55 (GND), U13.58 (GND), U13.64 (WAKE_N), U13.66 (XOSC0), U13.80 (GND), U13.114 (GND), U14.4 (GND), U14.5 (DIR), U15.2 (GND), U22.4 (GND), U22.5 (DIR), U22.6 (2B); also elsewhere on the board
unnamed: C46.1, R35.1, Y1.2
unnamed: C47.1, U13.88 (OSC0), Y1.1
unnamed: JP2.1, R32.1
unnamed: P4.1, R26.2
unnamed: R31.1, U15.8 (RS)
unnamed: R33.2, SW2.2
unnamed: R35.2, U13.89 (OSC1)
unnamed: R36.2, U13.59 (RBIAS)

Notes on the sheet:
0.1u - 2.2u at pin 115 0.1u at pin 87
one 0.1u decoupling cap close to each VDD pin
1% tolerance NP0 capacitor
25MHz
CONNECT JUMPER FOR FACTORY RESET ON NEXT SYSTEM RESET

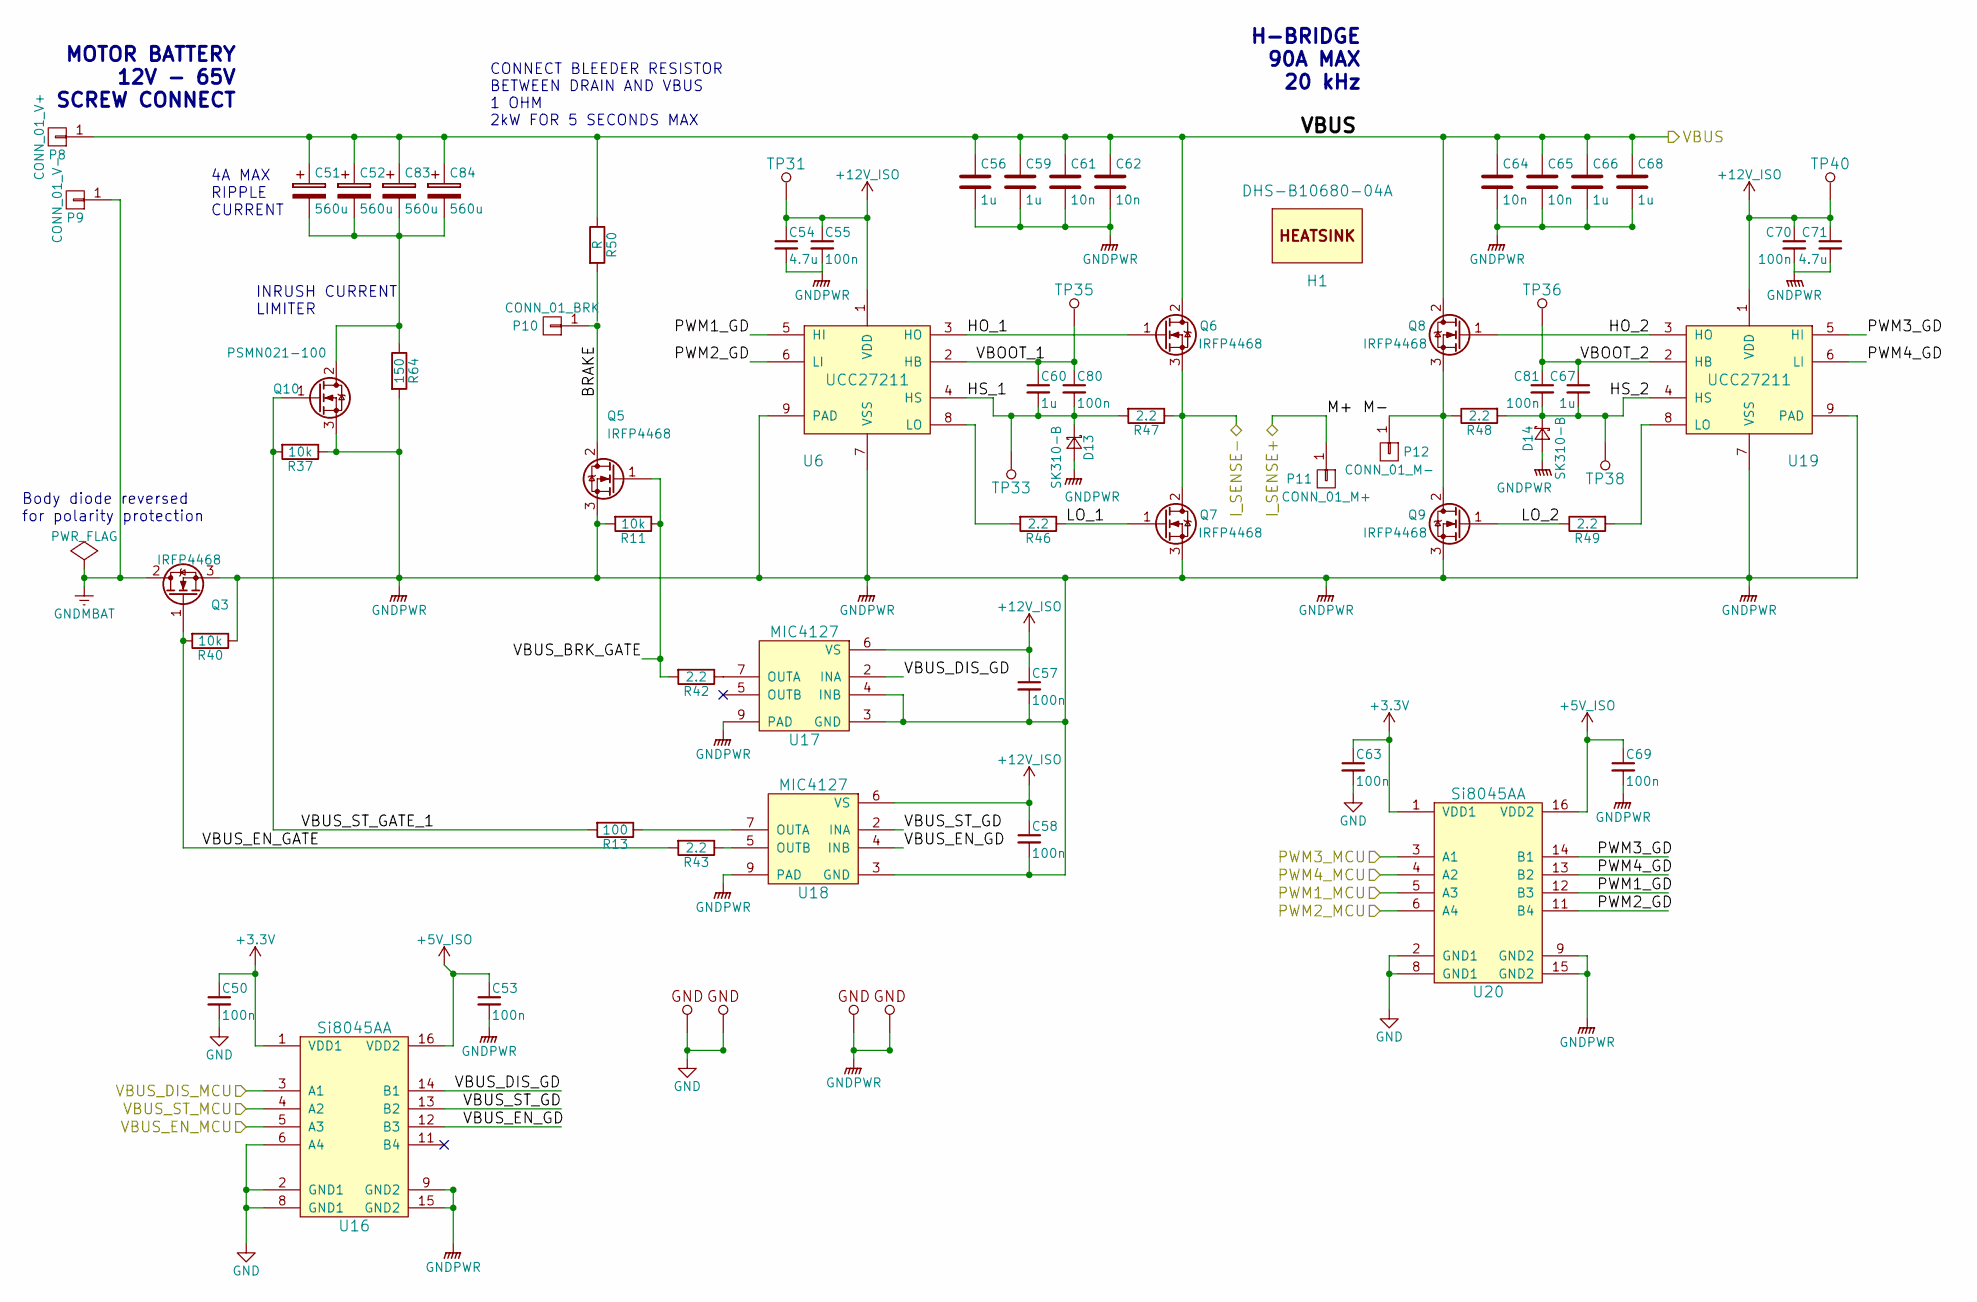
[picture p6: schematic h-bridge.sch]

Parts:
C50, C63: 100n; C_0603; Voltage 16V
C51, C52, C83, C84: 560u; CP18
C53, C55, C57, C58, C69, C70, C80, C81: 100n; C_0603; Voltage 25V
C54, C71: 4.7u; C_0805; Voltage 25V
C56, C59, C66, C68: 1u; C_1206; Voltage 100V
C60, C67: 1u; C_0603; Voltage 25V
C61, C62, C64, C65: 10n; C_0603; Voltage 100V
D13, D14: SK310-B; DO-214AA
GND1, GND2, GND8, GND9: GND_POINT; Pin_Header_Straight_1x01
H1: DHS-B10680-04A
P8: CONN_01_V+; M6_4AWG_LUG_TERM
P9: CONN_01_V-; M6_4AWG_LUG_TERM
P10: CONN_01_BRK; M6_4AWG_LUG_TERM
P11: CONN_01_M+; M6_4AWG_LUG_TERM
P12: CONN_01_M-; M6_4AWG_LUG_TERM
Q3, Q5, Q6, Q7, Q8, Q9: IRFP4468; TO-247_Horizontal_Neutral123_MountFromLS_largePads
Q10: PSMN021-100; SOT-669_LFPAK_ThermalVias-1
R11, R37, R40: 10k; R_0603
R13: 100; R_0603
R42, R43, R46, R47, R48, R49: 2.2; R_0603
R50: R
R64: 150; RESISTOR_FMP200
TP31, TP33, TP35, TP36, TP38, TP40: TEST_POINT; TEST_PAD_1.27mm
U6, U19: UCC27211; SOIC-8-1EP_3.9x4.9mm_Pitch1.27mm
U16, U20: Si8045AA; QSOP-16_3.9x4.9mm_Pitch0.635mm
U17, U18: MIC4127; SOIC-8-1EP_3.9x4.9mm_Pitch1.27mm

Connections:
+5V_ISO: C53.1, C69.1, U16.16 (VDD2), U20.16 (VDD2); also elsewhere on the board
+12V_ISO: C54.1, C55.1, C57.1, C58.1, C70.1, C71.1, TP31.1, TP40.1, U6.1 (VDD), U17.6 (VS), U18.6 (VS), U19.1 (VDD); also elsewhere on the board
/h-bridge/BRAKE: P10.1, Q5.2 (D)
/h-bridge/HO_1: Q6.1 (G), U6.3 (HO)
/h-bridge/HO_2: Q8.1 (G), U19.3 (HO)
/h-bridge/HS_1: C60.2, C80.2, D13.1 (K), R47.2, TP33.1, U6.4 (HS)
/h-bridge/HS_2: C67.2, C81.2, D14.1 (K), R48.2, TP38.1, U19.4 (HS)
/h-bridge/I_SENSE+: P11.1; also elsewhere on the board
/h-bridge/I_SENSE-: Q6.3 (S), Q7.2 (D), R47.1; also elsewhere on the board
/h-bridge/LO_1: Q7.1 (G), R46.1
/h-bridge/LO_2: Q9.1 (G), R49.1
/h-bridge/M-: P12.1, Q8.3 (S), Q9.2 (D), R48.1
/h-bridge/PWM1_GD: U6.5 (HI), U20.12 (B3)
/h-bridge/PWM1_MCU: U20.5 (A3); also elsewhere on the board
/h-bridge/PWM2_GD: U6.6 (LI), U20.11 (B4)
/h-bridge/PWM2_MCU: U20.6 (A4); also elsewhere on the board
/h-bridge/PWM3_GD: U19.5 (HI), U20.14 (B1)
/h-bridge/PWM3_MCU: U20.3 (A1); also elsewhere on the board
/h-bridge/PWM4_GD: U19.6 (LI), U20.13 (B2)
/h-bridge/PWM4_MCU: U20.4 (A2); also elsewhere on the board
/h-bridge/VBOOT_1: C60.1, C80.1, TP35.1, U6.2 (HB)
/h-bridge/VBOOT_2: C67.1, C81.1, TP36.1, U19.2 (HB)
/h-bridge/VBUS: C51.1, C52.1, C56.1, C59.1, C61.1, C62.1, C64.1, C65.1, C66.1, C68.1, C83.1, C84.1, P8.1, Q6.2 (D), Q8.2 (D), R50.1; also elsewhere on the board
/h-bridge/VBUS_BRK_GATE: Q5.1 (G), R11.1, R42.2
/h-bridge/VBUS_DIS_GD: U16.14 (B1), U17.2 (INA)
/h-bridge/VBUS_DIS_MCU: U16.3 (A1); also elsewhere on the board
/h-bridge/VBUS_EN_GATE: Q3.1 (G), R40.2, R43.2
/h-bridge/VBUS_EN_GD: U16.12 (B3), U18.4 (INB)
/h-bridge/VBUS_EN_MCU: U16.5 (A3); also elsewhere on the board
/h-bridge/VBUS_ST_GATE_1: Q10.1 (G), R13.2, R37.2
/h-bridge/VBUS_ST_GD: U16.13 (B2), U18.2 (INA)
/h-bridge/VBUS_ST_MCU: U16.4 (A2); also elsewhere on the board
GND: C50.2, C63.2, GND1.1, GND2.1, U16.2 (GND1), U16.6 (A4), U16.8 (GND1), U20.2 (GND1), U20.8 (GND1); also elsewhere on the board
GNDMBAT: P9.1, Q3.2 (D)
GNDPWR: C53.2, C54.2, C55.2, C56.2, C57.2, C58.2, C59.2, C61.2, C62.2, C64.2, C65.2, C66.2, C68.2, C69.2, C70.2, C71.2, D13.2 (A), D14.2 (A), GND8.1, GND9.1, Q3.3 (S), Q5.3 (S), Q7.3 (S), Q9.3 (S), Q10.3 (S), R11.2, R37.1, R40.1, R64.2, U6.7 (VSS), U6.9 (PAD), U16.9 (GND2), U16.15 (GND2), U17.3 (GND), U17.4 (INB), U17.9 (PAD), U18.3 (GND), U18.9 (PAD), U19.7 (VSS), U19.9 (PAD), U20.9 (GND2), U20.15 (GND2); also elsewhere on the board
unnamed: C51.2, C52.2, C83.2, C84.2, Q10.2 (D), R64.1
unnamed: R13.1, U18.7 (OUTA)
unnamed: R42.1, U17.7 (OUTA)
unnamed: R43.1, U18.5 (OUTB)
unnamed: R46.2, U6.8 (LO)
unnamed: R49.2, U19.8 (LO)

Notes on the sheet:
MOTOR BATTERY 12V - 65V SCREW CONNECT
CONNECT BLEEDER RESISTOR BETWEEN DRAIN AND VBUS 1 OHM 2kW FOR 5 SECONDS MAX
H-BRIDGE 90A MAX 20 kHz
Body diode reversed for polarity protection
INRUSH CURRENT LIMITER
4A MAX RIPPLE CURRENT

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
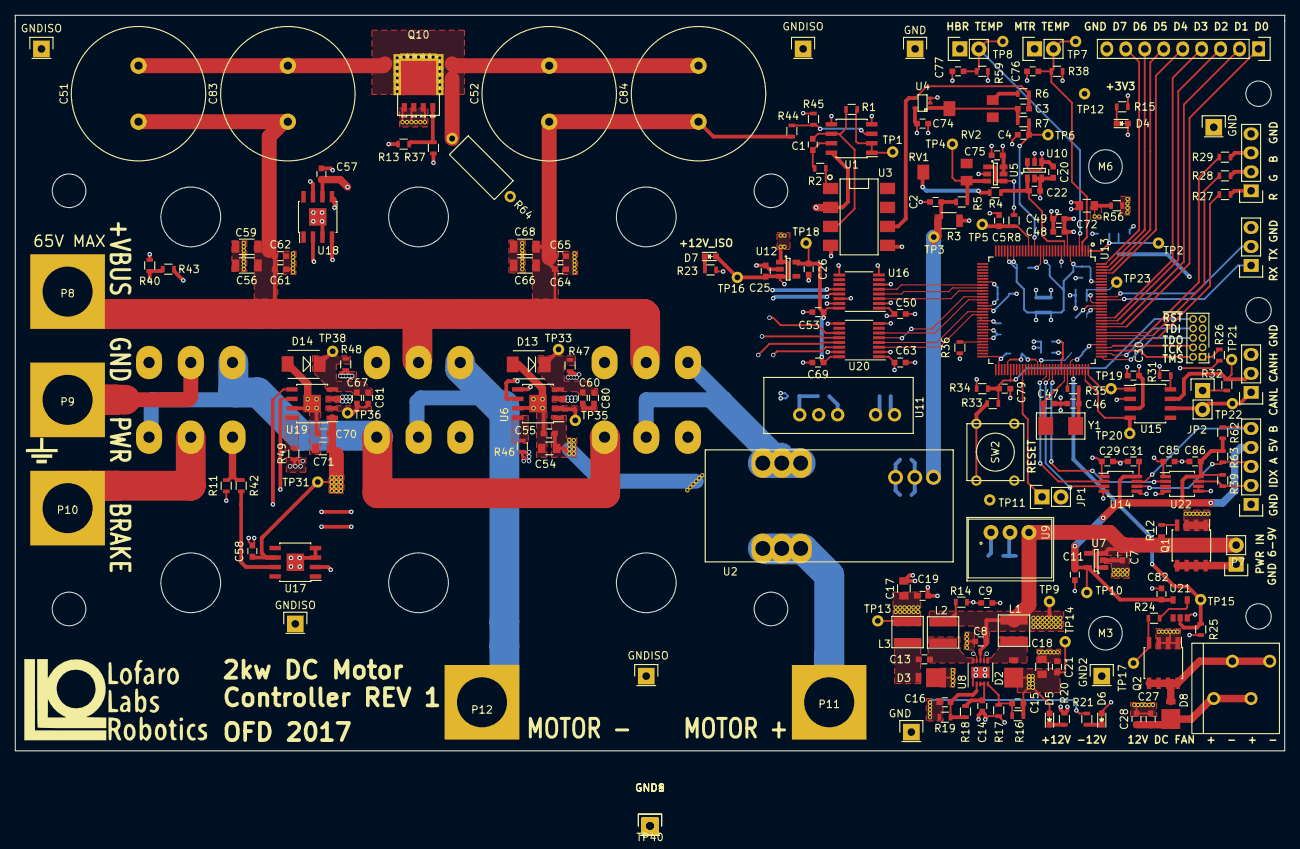
[picture p7: board 2kwMotorController.kicad_pcb from above]

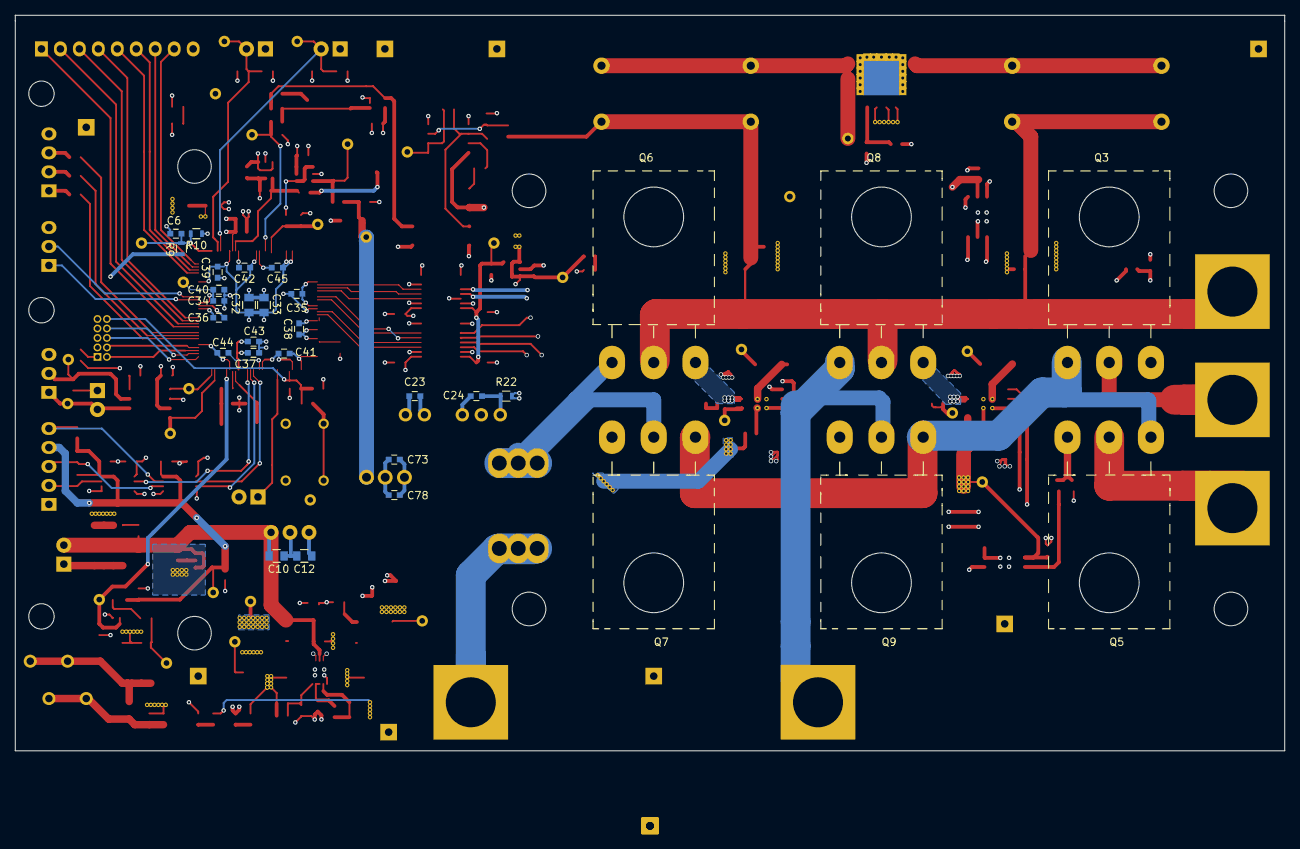
[picture p8: board 2kwMotorController.kicad_pcb from below]

Board: 4 copper layers, 170.0 x 98.5 mm, 245 parts (30 on the bottom side), 123 nets.

Other parts of the board:
GND: GND_POINT; Pin_Header_Straight_1x01
GND#2, GND#3: GND_POINT; Pin_Header_Straight_1x01
GNDISO: GND_POINT; Pin_Header_Straight_1x01
GNDISO#2, GNDISO#3, GNDISO#4: GND_POINT; Pin_Header_Straight_1x01
M3, M6: MOUNTING_HOLE; M4-SCREW-HOLE

Their connections:
GND: GND.1, GND#2.1, GND#3.1; also elsewhere on the board
GNDPWR: GNDISO.1, GNDISO#2.1, GNDISO#3.1, GNDISO#4.1; also elsewhere on the board
