ofdouglas/2kwMotorController/firmware/MotorController/startup.c

//*****************************************************************************
//
// Startup code for use with TI's Code Composer Studio and GNU tools.
//
// Copyright (c) 2011-2014 Texas Instruments Incorporated.  All rights reserved.
// Software License Agreement
// 
// Software License Agreement
//
// Texas Instruments (TI) is supplying this software for use solely and
// exclusively on TI's microcontroller products. The software is owned by
// TI and/or its suppliers, and is protected under applicable copyright
// laws. You may not combine this software with "viral" open-source
// software in order to form a larger program.
//
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
//*****************************************************************************

/*
 * startup.c - vector table, reset routine, and ISRs / fault handlers
 *
 *  Created on: Jun 26, 2017
 *      Author: Modified from TI source code by Oliver Douglas
 */

#include "stdinclude.h"
#include "driverlib/interrupt.h"

// File index for ASSERT() macro
FILENUM(0)

//*****************************************************************************
// Forward declaration of the default fault handlers.
//*****************************************************************************
void ResetISR(void);
static void NmiSR(void);
static void HardFault_Handler(void) __attribute__((naked));
static void IntDefaultHandler(void);

#ifndef HWREG
#define HWREG(x) (*((volatile uint32_t *)(x)))
#endif

//*****************************************************************************
// The entry point for the application.
//*****************************************************************************
extern int main(void);

//*****************************************************************************
// Reserve space for the system stack.
//*****************************************************************************
static uint32_t pui32Stack[128];

//*****************************************************************************
// External declarations for the interrupt handlers used by the application.
//*****************************************************************************
extern void xPortPendSVHandler(void);
extern void vPortSVCHandler(void);
extern void xPortSysTickHandler(void);

extern void adc0_seq0_ISR(void);
extern void adc1_seq0_ISR(void);
extern void qei_ISR(void);
extern void can_ISR(void);
extern void ls_timer_ISR(void);



//*****************************************************************************
// The vector table.  Note that the proper constructs must be placed on this to
// ensure that it ends up at physical address 0x0000.0000 or at the start of
// the program if located at a start address other than 0.
//*****************************************************************************
__attribute__ ((section(".intvecs")))
void (* const g_pfnVectors[])(void) =
{
    (void (*)(void))((uint32_t)pui32Stack + sizeof(pui32Stack)),
                                            // The initial stack pointer
    ResetISR,                               // The reset handler
    NmiSR,                                  // The NMI handler
    HardFault_Handler,                      // The hard fault handler
    IntDefaultHandler,                      // The MPU fault handler
    IntDefaultHandler,                      // The bus fault handler
    IntDefaultHandler,                      // The usage fault handler
    0,                                      // Reserved
    0,                                      // Reserved
    0,                                      // Reserved
    0,                                      // Reserved
    vPortSVCHandler,                        // SVCall handler
    IntDefaultHandler,                      // Debug monitor handler
    0,                                      // Reserved
    xPortPendSVHandler,                     // The PendSV handler
    xPortSysTickHandler,                    // The SysTick handler
    IntDefaultHandler,                      // GPIO Port A
    IntDefaultHandler,                      // GPIO Port B
    IntDefaultHandler,                      // GPIO Port C
    IntDefaultHandler,                      // GPIO Port D
    IntDefaultHandler,                      // GPIO Port E
    IntDefaultHandler,                      // UART0 Rx and Tx
    IntDefaultHandler,                      // UART1 Rx and Tx
    IntDefaultHandler,                      // SSI0 Rx and Tx
    IntDefaultHandler,                      // I2C0 Master and Slave
    IntDefaultHandler,                      // PWM Fault
    IntDefaultHandler,                      // PWM Generator 0
    IntDefaultHandler,                      // PWM Generator 1
    IntDefaultHandler,                      // PWM Generator 2
    qei_ISR,                                // Quadrature Encoder 0
    adc0_seq0_ISR,                          // ADC Sequence 0
    IntDefaultHandler,                      // ADC Sequence 1
    IntDefaultHandler,                      // ADC Sequence 2
    IntDefaultHandler,                      // ADC Sequence 3
    IntDefaultHandler,                      // Watchdog timer
    IntDefaultHandler,                      // Timer 0 subtimer A
    IntDefaultHandler,                      // Timer 0 subtimer B
    ls_timer_ISR,                           // Timer 1 subtimer A
    IntDefaultHandler,                      // Timer 1 subtimer B
    IntDefaultHandler,                      // Timer 2 subtimer A
    IntDefaultHandler,                      // Timer 2 subtimer B
    IntDefaultHandler,                      // Analog Comparator 0
    IntDefaultHandler,                      // Analog Comparator 1
    IntDefaultHandler,                      // Analog Comparator 2
    IntDefaultHandler,                      // System Control (PLL, OSC, BO)
    IntDefaultHandler,                      // FLASH Control
    IntDefaultHandler,                      // GPIO Port F
    IntDefaultHandler,                      // GPIO Port G
    IntDefaultHandler,                      // GPIO Port H
    IntDefaultHandler,                      // UART2 Rx and Tx
    IntDefaultHandler,                      // SSI1 Rx and Tx
    IntDefaultHandler,                      // Timer 3 subtimer A
    IntDefaultHandler,                      // Timer 3 subtimer B
    IntDefaultHandler,                      // I2C1 Master and Slave
    IntDefaultHandler,                      // CAN0
    can_ISR,                                // CAN1
    IntDefaultHandler,                      // Ethernet
    IntDefaultHandler,                      // Hibernate
    IntDefaultHandler,                      // USB0
    IntDefaultHandler,                      // PWM Generator 3
    IntDefaultHandler,                      // uDMA Software Transfer
    IntDefaultHandler,                      // uDMA Error
    adc1_seq0_ISR,                          // ADC1 Sequence 0
    IntDefaultHandler,                      // ADC1 Sequence 1
    IntDefaultHandler,                      // ADC1 Sequence 2
    IntDefaultHandler,                      // ADC1 Sequence 3
    IntDefaultHandler,                      // External Bus Interface 0
    IntDefaultHandler,                      // GPIO Port J
    IntDefaultHandler,                      // GPIO Port K
    IntDefaultHandler,                      // GPIO Port L
    IntDefaultHandler,                      // SSI2 Rx and Tx
    IntDefaultHandler,                      // SSI3 Rx and Tx
    IntDefaultHandler,                      // UART3 Rx and Tx
    IntDefaultHandler,                      // UART4 Rx and Tx
    IntDefaultHandler,                      // UART5 Rx and Tx
    IntDefaultHandler,                      // UART6 Rx and Tx
    IntDefaultHandler,                      // UART7 Rx and Tx
    IntDefaultHandler,                      // I2C2 Master and Slave
    IntDefaultHandler,                      // I2C3 Master and Slave
    IntDefaultHandler,                      // Timer 4 subtimer A
    IntDefaultHandler,                      // Timer 4 subtimer B
    IntDefaultHandler,                      // Timer 5 subtimer A
    IntDefaultHandler,                      // Timer 5 subtimer B
    IntDefaultHandler,                      // FPU
    0,                                      // Reserved
    0,                                      // Reserved
    IntDefaultHandler,                      // I2C4 Master and Slave
    IntDefaultHandler,                      // I2C5 Master and Slave
    IntDefaultHandler,                      // GPIO Port M
    IntDefaultHandler,                      // GPIO Port N
    0,                                      // Reserved
    IntDefaultHandler,                      // Tamper
    IntDefaultHandler,                      // GPIO Port P (Summary or P0)
    IntDefaultHandler,                      // GPIO Port P1
    IntDefaultHandler,                      // GPIO Port P2
    IntDefaultHandler,                      // GPIO Port P3
    IntDefaultHandler,                      // GPIO Port P4
    IntDefaultHandler,                      // GPIO Port P5
    IntDefaultHandler,                      // GPIO Port P6
    IntDefaultHandler,                      // GPIO Port P7
    IntDefaultHandler,                      // GPIO Port Q (Summary or Q0)
    IntDefaultHandler,                      // GPIO Port Q1
    IntDefaultHandler,                      // GPIO Port Q2
    IntDefaultHandler,                      // GPIO Port Q3
    IntDefaultHandler,                      // GPIO Port Q4
    IntDefaultHandler,                      // GPIO Port Q5
    IntDefaultHandler,                      // GPIO Port Q6
    IntDefaultHandler,                      // GPIO Port Q7
    IntDefaultHandler,                      // GPIO Port R
    IntDefaultHandler,                      // GPIO Port S
    IntDefaultHandler,                      // SHA/MD5 0
    IntDefaultHandler,                      // AES 0
    IntDefaultHandler,                      // DES3DES 0
    IntDefaultHandler,                      // LCD Controller 0
    IntDefaultHandler,                      // Timer 6 subtimer A
    IntDefaultHandler,                      // Timer 6 subtimer B
    IntDefaultHandler,                      // Timer 7 subtimer A
    IntDefaultHandler,                      // Timer 7 subtimer B
    IntDefaultHandler,                      // I2C6 Master and Slave
    IntDefaultHandler,                      // I2C7 Master and Slave
    IntDefaultHandler,                      // HIM Scan Matrix Keyboard 0
    IntDefaultHandler,                      // One Wire 0
    IntDefaultHandler,                      // HIM PS/2 0
    IntDefaultHandler,                      // HIM LED Sequencer 0
    IntDefaultHandler,                      // HIM Consumer IR 0
    IntDefaultHandler,                      // I2C8 Master and Slave
    IntDefaultHandler,                      // I2C9 Master and Slave
    IntDefaultHandler,                      // GPIO Port T
    IntDefaultHandler,                      // Fan 1
    0,                                      // Reserved
};

//*****************************************************************************
// The following are constructs created by the linker, indicating where the
// the "data" and "bss" segments reside in memory.  The initializers for the
// for the "data" segment resides immediately following the "text" segment.
//*****************************************************************************
extern uint32_t __data_load__;
extern uint32_t __data_start__;
extern uint32_t __data_end__;
extern uint32_t __bss_start__;
extern uint32_t __bss_end__;

//*****************************************************************************
// This is the code that gets called when the processor first starts execution
// following a reset event.  Only the absolutely necessary set is performed,
// after which the application supplied entry() routine is called.  Any fancy
// actions (such as making decisions based on the reset cause register, and
// resetting the bits in that register) are left solely in the hands of the
// application.
//*****************************************************************************
void
ResetISR(void)
{
    uint32_t *pui32Src, *pui32Dest;

    // Copy the data segment initializers from flash to SRAM.
    pui32Src = &__data_load__;
    for(pui32Dest = &__data_start__; pui32Dest < &__data_end__; )
        *pui32Dest++ = *pui32Src++;

    // Zero fill the bss segment.
    __asm("    ldr     r0, =__bss_start__\n"
          "    ldr     r1, =__bss_end__\n"
          "    mov     r2, #0\n"
          "    .thumb_func\n"
          "zero_loop:\n"
          "        cmp     r0, r1\n"
          "        it      lt\n"
          "        strlt   r2, [r0], #4\n"
          "        blt     zero_loop");

    // Enable the floating-point unit.  This must be done here to handle the
    // case where main() uses floating-point and the function prologue saves
    // floating-point registers (which will fault if floating-point is not
    // enabled).  Any configuration of the floating-point unit using DriverLib
    // APIs must be done here prior to the floating-point unit being enabled.
    // Note that this does not use DriverLib since it might not be included in
    // this project.
    HWREG(0xE000ED88) = ((HWREG(0xE000ED88) & ~0x00F00000) | 0x00F00000);
    
    // Call the application's entry point.
    main();
}


static void NmiSR(void)
{
    // Enter an infinite loop.
    while(1)
    {
    }
}

static void IntDefaultHandler(void)
{
    IntMasterDisable();
    log_msg_panic("\nFATAL ERROR: unregistered IRQ\n", 0, 0, 0);
    while(1)
        ;
}

/* Fault diagnostics code provided by FreeRTOS.
 */
static void HardFault_Handler(void)
{
    __asm volatile
    (
        " tst lr, #4                                                \n"
        " ite eq                                                    \n"
        " mrseq r0, msp                                             \n"
        " mrsne r0, psp                                             \n"
        " ldr r1, [r0, #24]                                         \n"
        " ldr r2, handler2_address_const                            \n"
        " bx r2                                                     \n"
        " handler2_address_const: .word prvGetRegistersFromStack    \n"
    );
}

/* Fault diagnostics code provided by FreeRTOS.
 */
void prvGetRegistersFromStack(uint32_t *pulFaultStackAddress)
{
    /* These are volatile to try and prevent the compiler/linker optimising them
    away as the variables never actually get used.  If the debugger won't show the
    values of the variables, make them global by moving their declaration outside
    of this function. */
    volatile uint32_t r0;
    volatile uint32_t r1;
    volatile uint32_t r2;
    volatile uint32_t r3;
    volatile uint32_t r12;
    volatile uint32_t lr; /* Link register. */
    volatile uint32_t pc; /* Program counter. */
    volatile uint32_t psr;/* Program status register. */

    r0 = pulFaultStackAddress[0];
    r1 = pulFaultStackAddress[1];
    r2 = pulFaultStackAddress[2];
    r3 = pulFaultStackAddress[3];

    r12 = pulFaultStackAddress[4];
    lr = pulFaultStackAddress[5];
    pc = pulFaultStackAddress[6];
    psr = pulFaultStackAddress[7];

    log_msg_panic("\n\nFATAL ERROR: Hard Fault\n", 0, 0, 0);
    log_msg_panic("=======================\n", 0, 0, 0);
    log_msg_panic(" R0  = 0x%08x\n", r0, 0, 0);
    log_msg_panic(" R1  = 0x%08x\n", r1, 0, 0);
    log_msg_panic(" R2  = 0x%08x\n", r2, 0, 0);
    log_msg_panic(" R3  = 0x%08x\n", r3, 0, 0);
    log_msg_panic(" R12 = 0x%08x\n", r12, 0, 0);
    log_msg_panic(" LR  = 0x%08x\n", lr, 0, 0);
    log_msg_panic(" PC  = 0x%08x\n", pc, 0, 0);
    log_msg_panic(" PSR = 0x%08x\n", psr, 0, 0);

    for(;;);
}
