ofdouglas/2kwMotorController/firmware/MotorController/source/thermistor_lut.c

/*
 * thermistor_lut.c - Lookup table for NTC thermistor (temperature probe)
 *
 *  Created on: Oct 20, 2017
 *      Author: Oliver Douglas
 */

#include "stdinclude.h"

/* Convert resistance to degrees celsius for the NXRT15WB473FA1B030 thermistor.
 */
const float thermistor_table[] = {
    140.622879,     //R = 1000
    136.688433,     //R = 1100
    133.161338,     //R = 1200
    129.969914,     //R = 1300
    127.059490,     //R = 1400
    124.387473,     //R = 1500
    121.920066,     //R = 1600
    119.630031,     //R = 1700
    117.495112,     //R = 1800
    115.496901,     //R = 1900
    113.620014,     //R = 2000
    111.851465,     //R = 2100
    110.180202,     //R = 2200
    108.596743,     //R = 2300
    107.092896,     //R = 2400
    105.661538,     //R = 2500
    104.296441,     //R = 2600
    102.992126,     //R = 2700
    101.743751,     //R = 2800
    100.547019,     //R = 2900
    99.398095,  //R = 3000
    98.293549,  //R = 3100
    97.230297,  //R = 3200
    96.205559,  //R = 3300
    95.216819,  //R = 3400
    94.261794,  //R = 3500
    93.338409,  //R = 3600
    92.444765,  //R = 3700
    91.579131,  //R = 3800
    90.739915,  //R = 3900
    89.925656,  //R = 4000
    89.135006,  //R = 4100
    88.366723,  //R = 4200
    87.619657,  //R = 4300
    86.892742,  //R = 4400
    86.184990,  //R = 4500
    85.495480,  //R = 4600
    84.823356,  //R = 4700
    84.167818,  //R = 4800
    83.528121,  //R = 4900
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
};

/* Resistance measurement diagram:
 *
 *
 *   3.3v *--^v^v----*---^v^v--* GND
 *          r_const  |   r_therm
 *                  vin
 */

#define TABLE_STEP_OHMS     100
#define ADC_VOLTS_PER_BIT   (3.0 / 4096)
#define RCONST_OHMS         10000.0

static size_t table_size = sizeof(thermistor_table) / sizeof(thermistor_table[0]);


/* Determine temperature from NTC thermistor voltage divider, using linear
 * interpolation of the lookup table above.
 */
float celsius_from_adc_raw(uint32_t raw)
{
    float vin = raw * ADC_VOLTS_PER_BIT;
    float r_therm = RCONST_OHMS * vin / (3.3 - vin);

    int lower_index = r_therm / TABLE_STEP_OHMS - 1;
    int upper_index = r_therm / TABLE_STEP_OHMS;

    float rv = 0;
    if (lower_index < 0)
        rv = thermistor_table[0];
    else if (upper_index >= table_size)
        rv = thermistor_table[table_size-1];
    else {
        float lower = thermistor_table[lower_index];
        float upper = thermistor_table[upper_index];
        float slope = (upper - lower) / TABLE_STEP_OHMS;
        float dx = r_therm - (lower_index + 1) * TABLE_STEP_OHMS;
        rv = lower + slope * dx;
        return rv;
    }

    return rv;
}
