ofdouglas/2kwMotorController/firmware/MotorController/source/logger.c

/*
 * logger.c
 *
 *  Created on: Oct 3, 2017
 *      Author: Oliver Douglas
 */

#include "stdinclude.h"
#include "system.h"
#include "xprintf.h"
#include "driverlib/uart.h"

// File index for ASSERT() macro
FILENUM(5)


/******************************************************************************
 * Definitions
 *****************************************************************************/
#if BUILD_TARGET == BUILD_TARGET_LAUNCHPAD
#define DEBUG_UART_SYSCTL_PERIPH    SYSCTL_PERIPH_UART0
#define DEBUG_UART_BASE             UART0_BASE
#elif BUILD_TARGET == BUILD_TARGET_2KWMC_R0
#define DEBUG_UART_SYSCTL_PERIPH    SYSCTL_PERIPH_UART3
#define DEBUG_UART_BASE             UART3_BASE
#else
#error "BUILD_TARGET not defined!"
#endif

#define DEBUG_UART_BAUD             921600
#define DEBUG_UART_CONFIG           \
    (UART_CONFIG_WLEN_8 | UART_CONFIG_STOP_ONE | UART_CONFIG_PAR_NONE)
#define DEBUG_UART_BUFFER_SIZE      512





/******************************************************************************
 * Circular buffer for Debug UART TX
 *****************************************************************************/
static char tx_buffer[DEBUG_UART_BUFFER_SIZE];
static int buf_head;
static int buf_tail;

static int increment_mod_n(int x, int n)
{
    x++;
    if (x == n)
        x = 0;
    return x;
}

static bool buffer_is_full(void)
{
    return (increment_mod_n(buf_tail, DEBUG_UART_BUFFER_SIZE) == buf_head);
}

static bool buffer_is_empty(void)
{
    return buf_tail == buf_head;
}

static void buffer_put(unsigned char c)
{
    tx_buffer[buf_tail] = c;
    buf_tail = increment_mod_n(buf_tail, DEBUG_UART_BUFFER_SIZE);
}

static char buffer_get(void)
{
    char c = tx_buffer[buf_head];
    buf_head = increment_mod_n(buf_head, DEBUG_UART_BUFFER_SIZE);
    return c;
}


/******************************************************************************
 * Debug UART
 *****************************************************************************/



/* Refill the UART peripheral's hardware FIFO from the software buffer. When
 * the software buffer has been emptied, disable the trigger for this ISR.
 */
static void debug_uart_ISR(void)
{
    uint32_t status = UARTIntStatus(DEBUG_UART_BASE, true);
    UARTIntClear(DEBUG_UART_BASE, status);

    if (status == UART_INT_TX) {
        while (true) {
            if (buffer_is_empty()) {
                UARTIntDisable(DEBUG_UART_BASE, UART_INT_TX);
                break;
            } else if (UARTSpaceAvail(DEBUG_UART_BASE) == false) {
                break;
            } else {
                UARTCharPutNonBlocking(DEBUG_UART_BASE, buffer_get());
            }
        }
    }

    // else - should probably set a flag to indicate spurious interrupt
}


/* Queue a character for transmission. The software buffer is used as an
 * extension of the UART peripheral's hardware FIFO.
 */
static void debug_uart_putc(unsigned char c)
{
    if (buffer_is_empty() && UARTSpaceAvail(DEBUG_UART_BASE))
        UARTCharPutNonBlocking(DEBUG_UART_BASE, c);
    else {
        while (buffer_is_full())
            ; // Wait. The buffer should be sized so that this is rare.
        buffer_put(c);
        UARTIntEnable(DEBUG_UART_BASE, UART_INT_TX);
    }
}

/* Used for printing diagnostics after a fatal error. Interrupts will be
 * disabled and all threads halted, so we use a blocking write in the
 * context of a system fault handler.
 */
static void panic_putc(unsigned char c)
{
    UARTCharPut(DEBUG_UART_BASE, c);
}

/* Configure the UART peripheral. Receive functionality is not used.
 */
static void debug_uart_setup(void)
{
    MAP_SysCtlPeripheralEnable(DEBUG_UART_SYSCTL_PERIPH);
    UARTConfigSetExpClk(DEBUG_UART_BASE, system_get_sysclk_freq(),
                        DEBUG_UART_BAUD, DEBUG_UART_CONFIG);

    UARTFIFOLevelSet(DEBUG_UART_BASE, UART_FIFO_TX1_8, UART_FIFO_RX7_8);
    UARTFIFOEnable(DEBUG_UART_BASE);

    UARTIntRegister(DEBUG_UART_BASE, debug_uart_ISR);
}


/******************************************************************************
 * Logging task
 *****************************************************************************/

/* Log requests are sent to the logging task via this queue, which is initialized
 * by the system thread during startup.
 */
QueueHandle_t log_message_queue;

/* Queue a message for printing by the logging task. Return TRUE if the
 * message was queued, else FALSE.
 *
 * Do not call this function from an ISR!
 */
bool log_msg(const char * str, int32_t arg0, int32_t arg1, int32_t arg2)
{
    struct log_message msg;
    msg.str = str;
    msg.args[0] = arg0;
    msg.args[1] = arg1;
    msg.args[2] = arg2;

    return xQueueSend(log_message_queue, &msg, 0);
}

/* Queue a message for printing by the logging task. Return TRUE if a higher
 * priority task was woken (e.g. a context switch is required). The calling
 * ISR should end with  portYIELD_FROM_ISR(task_woken);
 *
 * Only call this function from an ISR!
 */
int log_msg_ISR(const char * str, int32_t arg0, int32_t arg1,
                          int32_t arg2)
{
    struct log_message msg;
    msg.str = str;
    msg.args[0] = arg0;
    msg.args[1] = arg1;
    msg.args[2] = arg2;

    BaseType_t task_woken;
    xQueueSendFromISR(log_message_queue, &msg, &task_woken);
    return task_woken;
}


/* Used for printing diagnostics after a fatal error. Interrupts will be
 * disabled and all threads halted, so we use a blocking write in the
 * context of a system fault handler.
 */
void log_msg_panic(const char * str, int32_t arg0, int32_t arg1,
                           int32_t arg2)
{
    xdev_out(panic_putc);
    xprintf(str, arg0, arg1, arg2);
}

void logger_task_code(void * arg)
{
    // set up
    (void) arg;
    debug_uart_setup();
    xdev_out(debug_uart_putc);

    xprintf("Logging Task Start\n");
    xprintf("******************\n");

    while (true) {
        struct log_message msg;
        xQueueReceive(log_message_queue, &msg, portMAX_DELAY);

        // Excess arguments will be safely ignored (C Standard sec. 7.19.6.1)
        xprintf(msg.str, msg.args[0], msg.args[1], msg.args[2]);
    }
}


/* Helper function for printing float values with integer printf specifiers.
 * We use this because xprintf does not support float printf specifiers.
 *
 * Example: (x = 1234, precision = 3) will yield { 1, 234 }. Then
 *  xprintf("%3d.%03d", 1, 234) will print "1.234".
 *
 * float analog_val = adc_results[i] * 3.3 / 4096;
 * struct real_int ri = real_int_from_float(analog_val, 3);
 * log_message("%AIN3 = %3d.%03dv\n", ri.whole, ri.fract, 0);
 */
struct real_int real_int_from_float(float x, int precision)
{
    int scale = 10;
    while (precision--)
        scale *= 10;

    struct real_int ri;
    ri.whole = (int)x;
    ri.fract = scale * (x - (int)x);
    return ri;
}
