ofdouglas/2kwMotorController/sim/fir-c/fir.c

/* typedef struct fir_filter { */
/*   float * const coeff; */
/*   float * delay_line; */
/*   unsigned length; */
/* }; */


/* float fir_calculate(fir_filter *fir, float x) */
/* { */
/*   unsigned length = fir->length; */
/*   float accum = 0 */

/*   int i; */
/*   for (i = 0; i < length; i++) */
/*     accum += (fir->delay_line)[i] * (fir->coeff)[length - i];  */
/* }  */
