ofdouglas/2kwMotorController/(commit log)

2017-08-13 HW: change tm4c1294ncpdt to kcpdt; change LT3487 to 3471
    [mcu.sch, power.sch, sensors.sch]
2017-08-17 cleaned up h-bridge; added digital isolators
    [2kwMotorController.sch, h-bridge.sch, mcu.sch, power.sch, sensors.sch]
2017-08-17 improved inrush limiter, isolator, added aux. gate drive
    [2kwMotorController.sch, h-bridge.sch, mcu.sch, power.sch, sensors.sch]
2017-08-21 added MCU caps, reset, jtag, crystal
    [mcu.sch, power.sch]
2017-08-21 ERC cleanup, begin pcbnew population
    [2kwMotorController.kicad_pcb, 2kwMotorController.sch, h-bridge.sch, mcu.sch, power.sch, sensors.sch]
2017-08-23 hw: minor tweaks
    [2kwMotorController.kicad_pcb, h-bridge.sch, mcu.sch, sensors.sch]
2017-09-01 Improved current sensor and simplified power supplies
    [mcu.sch, power.sch, sensors.sch]
2017-09-04 Chose components and simulated LT3471
    [power.sch, sensors.sch]
2017-09-07 Finish MCU HW draft 1; adjust sensors for 3v ref
    [2kwMotorController.sch, h-bridge.sch, mcu.sch, power.sch, sensors.sch]
2017-09-12 Update sensors, hbridge caps, add heatsink
    [2kwMotorController.kicad_pcb, 2kwMotorController.sch, digikey-bom.csv, h-bridge.sch, mcu.sch, power.sch, sensors.sch]
2017-09-13 Layout first draft
    [2kwMotorController.kicad_pcb, h-bridge.sch, mcu.sch, power.sch, sensors.sch]
2017-09-14 revised power layout
    [2kwMotorController.kicad_pcb, h-bridge.sch, power.sch, powerBoard.kicad_pcb, sensors.sch]
2017-09-16 Added most footprints, did non-power layout
    [2kwMotorController.kicad_pcb, h-bridge.sch, mcu.sch, power.sch, powerBoard.kicad_pcb, sensors.sch]
2017-09-16 H-bridge decoupling, footprints, mechanical
    - Finished H-bridge decoupling study and chose H-bridge caps
    - Changed LT3471 inductors to those found in reference design,
    made footprints for them
    - Swapped Si86xx isolator for Si80xx (smaller package)
    - Updated heatsink footprint with correct screw sizes
    - Created mechanical hole footprints (M3, M4 screws)
    [1280A.DSN, 1280A.pcb, 1280acf.xls, 2kwMotorController.kicad_pcb, digikey-bom.csv, h-bridge.sch, mcu.sch, power.sch]
2017-09-17 Bulk cap layout, diodes, lugs, leds, trimpots
    - Moved H-bridge bulk capacitors to horizontal layout
    - Changed H-bridge and fan diodes to 100V schottky
    - Made 4AWG lug mount footprint, added lugs to BOM
    - Tweaked LED resistor values, added LEDs to BOM
    - Made trimpot footprint, added trimpots to BOM
    - Added snubber to ferrite bead circuit; also added FB to BOM
    [2kwMotorController.kicad_pcb, digikey-bom.csv, h-bridge.sch, mcu.sch, power.sch, sensors.sch]
2017-09-17 Inrush circuit, mounting hole position, temp sensor
    - Split inrush circuit (one for each bulk cap). Replaced NTC
    thermistor with 2W power resistor. Replaced D2Pak MOSFET with
    LFPAK MOSFETs.
    - Approximate position of mechanical holes chosen.
    - Added thermistor temp sensor circuits.
    [2kwMotorController.kicad_pcb, digikey-bom.csv, h-bridge.sch, mcu.sch, power.sch, sensors.sch]
2017-09-18 High amp routes, sensors
    - Adjusted high current routing to improve clearances. Recommend
    3mm high busbar to compensate for reduced busbar width to 2mm.
    - Shrank TO-247 pads by 1mm (lengthwise) to improve busbar clearance.
    - Removed unecessary buffers / SAR ADC drive circuits from low-bandwidth
    sensors.
    [2kwMotorController.kicad_pcb, h-bridge.sch, mcu.sch, power.sch, sensors.sch]
2017-09-18 Draft layout of controller section
    [2kwMotorController.sch, h-bridge.sch, mcu.sch, power.sch, sensors.sch]
2017-09-22 Gate driver layout mostly complete
    - Gate driver layout
    - Switch LM5102 for UCC27211 (higher current, more robust)
    - Tweak gate drive circuit passives
    - No soldermask on high-current traces
    - Fix error in orientation of LAH-100P footprint
    - Improved draft layout of control section
    [2kwMotorController.kicad_pcb, 2kwMotorController.sch, h-bridge.sch, mcu.sch, power.sch, sensors.sch]
2017-09-23 more layout progress
    [2kwMotorController.kicad_pcb, _saved_mcu.sch, _saved_power.sch, digikey-bom.csv, h-bridge.sch]
2017-09-24 All routing finished
    [2kwMotorController.kicad_pcb, _saved_mcu.sch, _saved_power.sch, h-bridge.sch, mcu.sch, power.sch, sensors.sch]
2017-09-24 layout cleanup, add buffer for fan drive
    [2kwMotorController.kicad_pcb, _saved_power.sch]
2017-09-25 All DRC/ERC passed
    [2kwMotorController.kicad_pcb, _saved_power.sch, h-bridge.sch, mcu.sch, power.sch, sensors.sch]
2017-09-25 tweaks, testpoints, decluttering
    [2kwMotorController.kicad_pcb, _saved_h-bridge.sch, digikey-bom.csv, mcu.sch, power.sch]
2017-09-26 Rev 0 board finished and submitted for manufacture
    [2kwMotorController.kicad_pcb, _saved_h-bridge.sch, h-bridge.sch]
2017-09-28 Create and verify full Digikey BOM
    [2kwMotorController-BOM.csv, 2kwMotorController.csv, 2kwMotorController.xml, digikey-bom-full.csv, digikey-bom-partial-extras.csv, h-bridge.sch, mcu.sch, power.sch]
2017-10-02 Software architecture first draft
    [1280A.DSN, 1280A.pcb, 1280acf.xls, 2kwMotorController.kicad_pcb]
2017-10-03 Firmware started; logging task finished
    [2kwMotorController.kicad_pcb, mcu.sch]
2017-10-20 Rev 0 Board Bring-Up Started
    PCB mostly assembled; errors noted in notes/rev0-mistakes.
    Logging task and status LED features tested on-board.
    Stubs for control and sensor code written, partially filled in.
    [2kwMotorController.csv]
2017-11-04 Open Loop Test Code
    Rough version of control task for open loop testing of H-bridge
    Rough version of sensor code
    [2kwMotorController.sch, h-bridge.sch, mcu.sch, power.sch, sensors.sch]
2017-11-09 basic velocity controller added
2017-11-12 Commit before starting PCB Rev 1 changes
2017-11-13 Revised layout mostly complete
    [2kwMotorController.kicad_pcb, h-bridge.sch, mcu.sch, power.sch, sensors.sch]
2017-11-14 Rev 1 layout finished
    [2kwMotorController.kicad_pcb, 2kwMotorController.sch, mcu.sch, power.sch]
2017-11-17 minor hw changes to submit PCB Rev 1
    [2kwMotorController.kicad_pcb, sensors.sch]
2017-11-17 Added CAN driver, draft of config/sys regs
2017-11-18 CAN driver and basic Python interface working
2017-11-19 Bug fixes and tweaks in firmware and python interface
    [2kwMotorController.csv, 2kwMotorController.xml, digikey-bom-full-rev1.csv, digikey-bom-partial-rev1.csv]
2017-11-21 Sensor firmware refactor, bugfixes
    [can.c, command.py, control.c, main.c, main.py, registers.py, sensors.c, sensors.h]
2017-11-22 basic RPi PWM read
2017-11-27 Bugfixes and python terminal display
    [2kwMotorController.kicad_pcb, h-bridge.sch, mcu.sch, power.sch, sensors.sch]
2017-12-03 Update BOM
    [2kwMotorController.csv, digikey-bom-full-rev1.csv, digikey-bom-full.csv, digikey-bom-partial-extras.csv, digikey-bom-partial-rev1.csv, h-bridge.sch, power.sch, sensors.sch]
2017-12-03 Fix update BOM commit
    [2kwMotorController-final.csv]
2017-12-03 cleanup & add gerbers
    [2kwMotorController-NPTH.DRL, 2kwMotorController.DRL, 2kwMotorController.GBL, 2kwMotorController.GBO, 2kwMotorController.GBS, 2kwMotorController.GTL, 2kwMotorController.GTO, 2kwMotorController.GTP]
